guilatriche/rover/docs/journal/journal-2026-11-05.md

# Journal de bord du rover : 2026-11-05

> **Projet** : 243-6J7-LI (préparation 243-5J4-LI)  
> **Auteur** : Guillaume Retier  
> **Règle** : une entrée datée par séance. Aucun mot de passe ni jeton dans ce fichier.

**Sommaire** : [Résumé](#résumé) · [Lexique](#lexique) · [Ce qui a été fait](#ce-qui-a-été-fait) · [Problèmes rencontrés](#problèmes-rencontrés) · [Décisions](#décisions) · [À faire](#à-faire)

## Résumé

**En bref** : première preuve de concept de la commande des moteurs. Une broche de l'ESP32 (la carte de commande) envoie des impulsions à l'entrée S1 de la Sabertooth (la carte qui fait tourner les moteurs), à travers un transistor 2N3904 (un interrupteur électronique). Essais à la maison, avec le robot et un multimètre (pas d'oscilloscope), roues en l'air.

**Points clés**

- **Le montage commande bien la Sabertooth.** Le multimètre affiche la moyenne de la tension sur S1 : 400 mV à 1500 µs, 431 mV à 1600 µs, 455 mV à 1700 µs, conformes au calcul à 1 % près. Comme on n'a pas d'oscilloscope, c'est la preuve que les impulsions ont la bonne durée.
- **Réponse de la Sabertooth** : au-dessus du centre les roues avancent, en dessous elles reculent, avec la même vitesse de part et d'autre à écart égal. La vitesse augmente avec l'écart au centre.
- **Le centre (l'arrêt) est la largeur d'impulsion reçue à l'allumage de la Sabertooth.** Elle l'apprend elle-même (autocalibration) et le conserve quand seule l'ESP32 redémarre. Il a été décalé à 1400 µs, puis remis à 1500 µs, en allumant la Sabertooth au bon moment. Pourquoi c'est important : si la Sabertooth redémarre pendant que l'ESP32 envoie autre chose que 1500 µs, l'arrêt change et le robot peut bouger.
- **ESP32 coupée** (USB ou batterie) : les roues s'arrêtent en moins d'une seconde, parce que dans ce mode la Sabertooth s'arrête quand les impulsions cessent.
- **Programme figé** : sans protection, les roues ne s'arrêtent pas, car la partie de l'ESP32 qui fabrique les impulsions continue d'émettre seule. Avec une minuterie de surveillance de 2 s, l'ESP32 redémarre et les roues s'arrêtent.
- **Une entrée de la Sabertooth laissée sans branchement capte le bruit électrique** (S1 libre touchée au doigt, S2 sans branchement) et les roues bougent. Aucune entrée ne doit rester libre sur le circuit imprimé.

## Lexique

| Mot | Ce que c'est |
| --- | --- |
| ESP32 | La carte de commande : l'ordinateur du robot, qui envoie les ordres aux moteurs |
| Sabertooth | La carte qui fait tourner les moteurs d'après les ordres reçus |
| GPIO 18 | Une broche de l'ESP32 (une « sortie ») qui envoie le signal vers S1 |
| S1 et S2 | Les deux entrées de la Sabertooth par lesquelles elle reçoit les ordres : S1 pour un côté du robot, S2 pour l'autre |
| Mode radiocommande | La façon dont la Sabertooth lit ses ordres : comme ceux d'une télécommande de modèle réduit, par des impulsions |
| Impulsion, µs | L'ordre est la durée d'une impulsion, en microsecondes (µs). Environ 1500 µs = arrêt, moins = arrière, plus = avant |
| Centre | La largeur d'impulsion qui correspond à l'arrêt. Dans ce mode, la Sabertooth l'apprend toute seule à son allumage (autocalibration) |
| Transistor | Un interrupteur électronique : un petit courant sur une patte (la base) ouvre ou ferme le passage entre deux autres pattes |
| Résistance de rappel | Une résistance qui ramène un fil à une tension connue (ici 5 V) quand rien d'autre ne le pilote |
| Multimètre | L'appareil de mesure de tension. Trop lent pour suivre les impulsions, il en affiche la moyenne |
| Minuterie de surveillance | Un mécanisme qui redémarre l'ESP32 si son programme se bloque |
| 0 V, masse | Le point de référence de toutes les tensions, relié entre la Sabertooth et l'ESP32 |
| Roues en l'air | Les roues ne touchent pas le sol, pour que le robot ne parte pas en cas de problème |

## Ce qui a été fait

### Matériel

- ESP32 (carte LilyGO T-A7670E), alimentée par son câble USB ou par sa batterie.
- Contrôleur de moteurs Sabertooth Dual 5A Reg, 4 moteurs du châssis Lynxmotion A4WD1 (deux côtés de deux roues : S1 commande un côté, S2 l'autre).
- Pile lithium 3S (12,32 V mesurés) avec fusible de 3 A.
- Un transistor 2N3904 et deux résistances de 10 kΩ.
- Multimètre (tension continue). Pas d'oscilloscope ni d'alimentation de laboratoire pour cette séance.

### Montage

Brochage du 2N3904 (boîtier TO-92) : face plate vers soi, pattes vers le bas, de gauche à droite : émetteur (E), base (B), collecteur (C).

1. GPIO 18 de l'ESP32 → résistance R1 de 10 kΩ → base (B).
2. Émetteur (E) → masse commune. La masse de l'ESP32 (GND) est reliée au 0V du Sabertooth ; sans cette liaison, le signal n'a pas de référence commune.
3. Collecteur (C) → borne S1 du Sabertooth.
4. Collecteur (C) → résistance R2 de 10 kΩ (résistance de rappel) → borne 5V du Sabertooth.
5. Pile 3S → fusible de 3 A → bornes d'alimentation du Sabertooth. Une inversion de polarité détruit le contrôleur : vérifier le + et le − avant de brancher.
6. Interrupteurs du Sabertooth (la Sabertooth ne les lit qu'à l'allumage) : 1 bas et 2 haut = mode radiocommande ; 3 bas = coupure pour pile lithium (elle arrête les moteurs quand la tension de la pile devient trop basse, ce qui protège la pile) ; 4 bas = les deux côtés indépendants ; 5 haut = réponse linéaire ; 6 haut = radiocommande standard : la Sabertooth apprend seule le centre et coupe les moteurs quand les impulsions cessent.
7. Moteurs branchés, **roues en l'air** pour tous les essais ; pile à portée de main pour la débrancher.

Rôle des pièces :

- **Transistor** : interrupteur vers la masse. L'ESP32 sort 3,3 V ; le Sabertooth attend des impulsions de type radiocommande dont le niveau haut est celui de sa borne 5V. Le transistor ramène S1 à 0 V ou le laisse monter à 5 V (choix expliqué dans le dossier, section 12).
- **R1 (10 kΩ)** : limite le courant dans la base. Quand la broche est haute, ce courant vaut (3,3 V − 0,65 V) / 10 kΩ = 0,265 mA.
- **R2 (10 kΩ, rappel)** : ramène S1 vers 5 V quand le transistor est bloqué. L'entrée S1 n'a pas de résistance interne vers le haut (lue à −3 mV quand rien n'y est branché), donc sans R2, S1 ne pourrait pas monter.
- Le signal est **inversé** : broche haute, le transistor conduit et S1 est à 0 V ; broche basse, le transistor est bloqué et S1 monte à 5 V. L'impulsion vue par le Sabertooth est donc le moment où la broche est basse.

Programmes d'essai : `test_06_transistor_sabertooth`, `test_07_sabertooth_sequence`, `test_08_minuterie_surveillance` (dossier `firmware/tests`). Le module Arduino-ESP32 (le support de l'ESP32 dans le logiciel Arduino) doit être en version 3.x (fonction `ledcAttach`) ; la version exacte reste à noter.

### Le signal et la mesure au multimètre

Le signal se répète toutes les 20 ms (50 fois par seconde). Dans chaque cycle de 20 ms, pour une impulsion de 1500 µs (1,5 ms) :

```
|<------------------ 20 ms ------------------>|
| 1,5 ms          |          18,5 ms           |
| GPIO 18 BAS     |        GPIO 18 HAUT        |
| transistor      |        transistor          |
| bloqué          |        conduit             |
| S1 = 5 V        |        S1 ≈ 0 V            |
```

1,5 + 18,5 = 20. La largeur de l'impulsion est le temps t pendant lequel S1 est à 5 V.

Le multimètre est trop lent pour suivre ces pointes une à une : il affiche la **moyenne** de la tension sur le cycle. Si la tension vaut V_haut pendant le temps t et V_bas le reste des 20 ms :

moyenne = V_haut × (t / 20 ms) + V_bas × (1 − t / 20 ms)

Plus l'impulsion est longue, plus la moyenne monte. C'est ce qui permet de contrôler la largeur de l'impulsion avec un multimètre, faute d'oscilloscope.

### Valeurs mesurées, calcul de chacune

Sonde noire du multimètre sur la masse commune (GND) pour toutes les mesures. Sonde rouge à l'endroit indiqué.

| N° | Point (sonde rouge) | Mesuré | Calculé |
| --- | --- | --- | --- |
| M1 | Broche 3V3 | 3,3 V | 3,3 V |
| M2 | GPIO 18 (1500 µs) | 3,04 V | 3,05 V |
| M3 | Base, entre R1 et le transistor | 600 mV | 0,60 V |
| M4 | Collecteur, sans R2 | 17,74 mV | sans objet |
| M5 | Collecteur, avec rappel au 3V3 | 3,26 V | environ 0,28 V (non conforme) |
| M6 | Collecteur, rappel 10 kΩ au 3V3, câblage corrigé | 276 mV | 0,2475 V + V_bas (sert à déduire V_bas) |
| M7 | Pile 3S | 12,32 V | 9 à 12,6 V |
| M8 | Borne 5V du Sabertooth | 4,98 V | 5 V |
| M9 | S1 seule, rien branché dessus | −3 mV | 0 V |
| M10 | S1 / collecteur, rappel au 5V, 1500 µs | 400 mV | 402 mV |
| M11 | Même point, 1600 µs | 431,3 mV | 427 mV |
| M12 | Même point, 1600 µs | 430 mV | 427 mV |
| M13 | Même point, 1700 µs | 455 mV | 452 mV |

**Broche 3V3 (3,3 V).** Tension fixe de l'ESP32. Vérifie que le multimètre et la masse sont corrects avant les autres mesures.

**GPIO 18 (3,05 V).** À 1500 µs, la broche est basse 1,5 ms et haute 18,5 ms par cycle (voir le schéma). Haute, elle est à 3,3 V ; basse, à 0 V. Moyenne = (3,3 × 18,5 + 0 × 1,5) / 20 = 61,05 / 20 = 3,05 V. Le rapport 18,5 / 20 est la part du cycle où la broche est haute, soit 92,5 %.

**Base (0,60 V).** Quand la broche est haute (92,5 % du cycle), la jonction base-émetteur conduit et la base reste à environ 0,65 V (valeur typique d'un 2N3904, entre 0,6 et 0,7 V). Quand la broche est basse, la base est à 0 V. Moyenne = 0,65 × 0,925 = 0,60 V. En sens inverse, 600 mV / 0,925 = 0,649 V, ce qui est compatible avec cette valeur typique.

**Collecteur sans R2 (17,74 mV).** Sans résistance de rappel, rien ne fait monter la tension du collecteur quand le transistor est bloqué : la lecture reste proche de 0 V. Cette lecture a montré que R2 manquait.

**Collecteur avec rappel au 3V3 (environ 0,28 V attendus).** Le collecteur est à 3,3 V pendant 1,5 ms (transistor bloqué) et à V_bas pendant 18,5 ms (transistor conducteur). V_bas est la petite tension qui reste aux bornes du transistor conducteur. Partie haute : 3,3 × 1,5 / 20 = 0,2475 V, à laquelle s'ajoute une petite tension de l'ordre de 0,03 V (voir la déduction ci-dessous), soit environ 0,28 V. Le 3,26 V lu en M5 est presque la tension du rappel (3,3 V) : le collecteur restait presque tout le temps haut, ce qui n'est pas ce que le calcul prévoit. Le câblage a été corrigé ensuite.

**Déduction de V_bas (0,031 V).** En M6, 276 mV mesurés. Partie haute : 0,2475 V. Il reste 0,276 − 0,2475 = 0,0285 V, apporté par la partie basse, qui occupe 18,5 / 20 = 0,925 du cycle. V_bas = 0,0285 / 0,925 = 0,031 V. Cette valeur est utilisée pour les calculs suivants ; la ligne M6 sert donc à la déduire et non à la vérifier.

**Pile 3S (12,32 V).** Trois éléments lithium en série : un élément vaut 3,0 V (vide) à 4,2 V (plein), soit 9 à 12,6 V pour trois. 12,32 / 3 = 4,11 V par élément : pile presque pleine.

**Borne 5V du Sabertooth (4,98 V).** Le Sabertooth fournit 5 V sur cette borne. Le 4,98 V mesuré est utilisé comme V_haut pour les calculs de S1.

**S1 seule (−3 mV).** Aucune pièce n'est branchée sur S1 et la lecture est proche de 0 V : l'entrée n'a pas de résistance interne vers le haut. C'est pour cela que R2 est nécessaire.

**S1 / collecteur, rappel au 5V.** V_haut = 4,98 V, V_bas = 0,031 V, t = largeur de l'impulsion.

- 1500 µs : S1 est haut 1,5 / 20 = 0,075 du cycle, bas le reste (0,925). 4,98 × 0,075 + 0,031 × 0,925 = 0,3735 + 0,0287 = 0,402 V. Mesuré : 400 mV.
- 1600 µs : 1,6 / 20 = 0,080 (haut), 0,920 (bas). 4,98 × 0,080 + 0,031 × 0,920 = 0,3984 + 0,0285 = 0,427 V. Mesuré : 431,3 mV et 430 mV.
- 1700 µs : 1,7 / 20 = 0,085 (haut), 0,915 (bas). 4,98 × 0,085 + 0,031 × 0,915 = 0,4233 + 0,0284 = 0,452 V. Mesuré : 455 mV.

Les écarts sont de −0,5 % (1500 µs), +1,0 % et +0,7 % (1600 µs) et +0,7 % (1700 µs).

**Courants à l'état conducteur.** I_B = (3,3 − 0,65) / 10 kΩ = 0,265 mA. I_C = 4,98 V / 10 kΩ = 0,50 mA (courant du rappel R2). I_C / I_B = 1,9, très inférieur au gain d'un 2N3904 : le transistor est saturé, donc il agit comme un interrupteur fermé.

**Résolution du programme.** duty = 65535 × (20000 − t) / 20000 (16 bits, 50 Hz). Un pas du générateur vaut 20 ms / 65536 = 0,31 µs. Pour 1500 µs, duty = 60619. Pourquoi : le réglage est assez fin pour fixer la largeur d'impulsion à moins de 1 µs près.

**En résumé.** Les mesures du multimètre, comparées au calcul, ne s'écartent que de 1 % au plus : le transistor donne bien des impulsions de la largeur voulue, et il fonctionne comme un interrupteur fermé quand il conduit. On peut donc se fier au montage pour la suite des essais, même sans oscilloscope.

### Essais

Procédure pour reproduire les essais de commande :

1. Pile du Sabertooth débranchée, téléverser le programme d'essai dans l'ESP32 (roues en l'air).
2. Pour fixer le centre à 1500 µs : ESP32 en marche avec le programme `test_06_transistor_sabertooth` (`PULSE_US = 1500`), couper l'interrupteur de la pile 12 V pendant 2 s, puis le rallumer. Les roues de S1 restent immobiles. Pourquoi : la Sabertooth prend pour centre la largeur reçue à son allumage ; l'allumer pendant que l'ESP32 envoie 1500 µs fixe donc l'arrêt à 1500 µs.
3. Téléverser ensuite le programme d'essai (`test_07_sabertooth_sequence` ou `test_08_minuterie_surveillance`) sans toucher à l'interrupteur 12 V : le centre reste à 1500 µs.
4. Noter, pour chaque largeur envoyée, si les roues de S1 tournent, dans quel sens et à quelle vitesse approximative. La valeur en cours est affichée sur le port série (115200) ; le début du démarrage peut manquer à l'écran après un redémarrage par USB.
5. Ne pas poser la pointe du multimètre sur le collecteur pendant que les roues tournent : cela les perturbe (voir le problème 6).

Chaque essai est présenté avec son but, ses conditions, son résultat et ce qu'on en conclut.

| N° | But | Conditions de test | Résultats | Conclusion |
| --- | --- | --- | --- | --- |
| 1 | Vérifier que les roues restent immobiles quand l'ESP32 envoie la largeur d'arrêt | 1500 µs constant | Roues immobiles | La largeur de 1500 µs est reconnue comme l'arrêt |
| 2 | Voir si une largeur différente de 1500 µs fait tourner les roues | 1600 µs envoyé en continu | Roues immobiles | Preuve de l'autocalibration : la Sabertooth avait pris 1600 µs pour centre à son allumage |
| 3 | Voir si les roues tournent au-dessus du centre et s'arrêtent au centre | 1500 µs pendant 5 s, puis 1600 / 1500 / 1700 / 1500 | Rotation à 1600 et 1700 µs, arrêt à 1500 µs | Les roues avancent au-dessus du centre et s'arrêtent au centre |
| 4 | Vérifier que le redémarrage de l'ESP32 ne fait pas bouger les roues | 1500 µs constant ; pile branchée, puis redémarrage de l'ESP32 | Roues immobiles | Le redémarrage de l'ESP32 seule ne fait pas bouger les roues |
| 5 | Vérifier que l'effet de 1600 µs et de 1500 µs se répète | 1500 µs pendant 5 s, puis 1600 / 1500 en boucle | Arrêt à 1500 µs, rotation à 1600 µs | Le comportement est répétable |
| 6 | Comparer l'avant et l'arrière à écart égal avec le centre | 1500 µs pendant 5 s, puis 1600 / 1500 / 1400 / 1500 | 1400 µs : arrière ; 1500 µs : arrêt ; 1600 µs : avant ; même vitesse à 1400 et à 1600 µs | La réponse est symétrique autour du centre |
| 7 | Voir ce qui arrive si la Sabertooth est allumée pendant que l'ESP32 envoie 1400 µs | Même programme ; Sabertooth allumée pendant la phase à 1400 µs | Arrêt à 1400 µs, 1500 µs avant lent, 1600 µs avant plus rapide | Le centre est devenu 1400 µs : la Sabertooth prend pour centre la largeur reçue à son allumage |
| 8 | Confirmer que le point d'arrêt dépend du moment où l'on allume la Sabertooth | Centre décalé en manœuvrant seulement l'interrupteur de la pile 12 V, ESP32 en marche | Le point d'arrêt change | Le point d'arrêt dépend de l'instant de l'allumage |
| 9 | Voir si le centre est conservé quand seule l'ESP32 redémarre | Redémarrage de l'ESP32 seule, Sabertooth restée allumée depuis l'essai précédent ; programme : 1500 µs pendant 5 s, puis 1600 µs | Roues en rotation pendant 5 s, arrêt à 1600 µs | Le centre reste en mémoire (1600 µs) quand seule l'ESP32 redémarre |
| 10 | Remettre le centre à 1500 µs | 1500 µs constant ; pile 12 V coupée 2 s puis rallumée | Roues immobiles | Une coupure de 2 s avec 1500 µs envoyé remet le centre à 1500 µs |
| 11 | Voir si les roues s'arrêtent quand l'ESP32 est coupée | Roues à 1600 µs ; câble USB de l'ESP32 débranché | Roues arrêtées en moins d'une seconde | Dans ce mode, la Sabertooth s'arrête quand les impulsions cessent |
| 12 | Vérifier que c'est pareil quand l'ESP32 est alimentée par sa batterie | Même essai ; ESP32 sur sa batterie seule | Même résultat ; à la remise sous tension, rotation reprise après environ 5 s (fin de la phase à 1500 µs) | Même conclusion, quelle que soit l'alimentation de l'ESP32 |
| 13 | Voir ce qui arrive aux roues quand le programme de l'ESP32 se fige, sans protection | Programme figé volontairement après le passage à 1600 µs, sans minuterie | Les roues ne s'arrêtent pas | Un programme figé laisse les roues sur la dernière vitesse : la partie de l'ESP32 qui fabrique les impulsions continue d'émettre seule |
| 14 | Vérifier que la minuterie de surveillance redémarre l'ESP32 et arrête les roues | Programme figé à 10 s, avec minuterie de surveillance de 2 s | L'ESP32 redémarre (message `rst:0xc (SW_CPU_RESET)`, qui indique un redémarrage commandé par le logiciel), les roues s'arrêtent ; `Impulsion : 1500 us` apparaît 0,19 s après le début du démarrage | La minuterie règle le cas du programme figé |
| 15 | Voir l'effet d'une entrée sans branchement | S1 libre (M9) | Un doigt sur le fil de S1 fait tourner les roues d'un côté | Une entrée libre capte le bruit : aucune entrée ne doit rester libre sur le circuit imprimé |
| 16 | Voir l'effet de S2 laissée sans branchement | S2 sans branchement toute la soirée | Ses roues tournent parfois seules : quand on touche son fil, quand son fil est approché de la pointe du multimètre posée sur le collecteur (ESP32 alimentée sur USB ou sur batterie), et de temps en temps pendant l'arrêt des roues de S1 | Même conclusion : relier S2 (voir À faire, B1) |
| 17 | Vérifier que ces mouvements viennent de l'ESP32 alimentée | ESP32 hors tension (USB débranché, batterie éteinte), pile du Sabertooth branchée | Aucune roue ne tourne | Les roues ne bougent pas quand l'ESP32 est hors tension |

Les essais du début de séance (dont l'essai 2, et d'autres non repris ici) ont eu lieu avant qu'on ait compris que le centre dépend du moment de l'allumage. On n'y avait pas noté si la Sabertooth était déjà allumée quand l'ESP32 envoyait les impulsions.

## Problèmes rencontrés

| # | Problème | Cause | Correctif |
| --- | --- | --- | --- |
| 1 | 17,74 mV au collecteur | Pas de résistance de rappel branchée | Résistance de 10 kΩ ajoutée |
| 2 | 3,26 V au collecteur avec le rappel (attendu ~0,28 V) | Câblage du transistor | Câblage corrigé ; 276 mV ensuite |
| 3 | 1,5 mV lus sur GPIO 18  | Masse du multimètre | Mesure écartée ; mesures suivantes conformes |
| 4 | L'arrêt change d'un démarrage à l'autre (début de séance) | Le Sabertooth prend pour centre la largeur reçue à son allumage | Démarrer toujours à 1500 µs ; voir À faire |
| 5 | Roues qui tournent quand on touche une entrée libre | Entrée sans branchement | Relier S2 ; aucune entrée libre sur le circuit imprimé |
| 6 | Pointe du multimètre sur le collecteur qui accélère des roues (sur S1 une première fois, sur S2 plus tard) | Cause non identifiée | Ne pas mesurer pendant que les roues tournent ; oscilloscope |
| 7 | Programme figé : les roues gardent la dernière vitesse | La partie de l'ESP32 qui fabrique les impulsions continue d'émettre seule, même quand le programme est bloqué | Minuterie de surveillance qui redémarre l'ESP32 |
| 8 | Roue de S1 qui rampe très lentement environ 2 s après l'arrêt, de temps en temps, vitesse variable | Cause non identifiée | À revoir au sol avec la charge du robot et à l'oscilloscope |
| 9 | Mouvements à la mise sous tension du Sabertooth (une paire d'environ 1 s lors d'une mise sous tension, l'autre paire d'environ un tour lors d'une autre) | Cause non identifiée ; non reproduits en redémarrant seulement l'ESP32 | À revoir à l'oscilloscope (comportement de GPIO 18 et des entrées à l'allumage) |

## Décisions

| Sujet | Décision | Pourquoi | Statut |
| --- | --- | --- | --- |
| Démarrage du programme du robot | Toujours 1500 µs au départ, et rester à 1500 µs tant que le serveur n'envoie pas d'ordre | La Sabertooth prend pour centre la largeur reçue à son allumage (essais 7 à 10) : si l'ESP32 envoie autre chose, l'arrêt est décalé et les roues bougent | Retenue (5 novembre) |
| Programme figé | Conserver la minuterie de surveillance ; délai de 2 s à fixer. La remise à zéro ne doit se faire que quand le travail utile est fait | Sans elle, un programme bloqué laisse les roues sur le dernier ordre (essai 13) ; avec elle, l'ESP32 redémarre et les roues s'arrêtent (essai 14). Remise à zéro seulement après le travail utile, sinon un blocage ne serait pas détecté | Retenue (5 novembre) |

## À faire

| Réf. | Tâche |
| --- | --- |
| B1 | Relier S2 à 0V (ou lui donner un signal) et refaire les essais ; les observations de S1 ne doivent plus être mélangées avec celles de S2 |
| B2 | Oscilloscope (cégep) : largeur d'impulsion autour de 1500 µs (±20 µs), niveaux ≥ 4,5 V et ≤ 0,5 V, comportement de GPIO 18 au démarrage et au redémarrage |
| B3 | Chronométrer le délai entre le blocage et l'arrêt (minuterie de 2 s) et le délai d'arrêt à la coupure de l'ESP32 |
| B4 | Allumage du Sabertooth et état sûr : choisir la solution (interrupteur sur l'alimentation du Sabertooth, relais ou transistor PNP / MOSFET à canal P, commandé par l'ESP32 ; interrupteur 6 en bas, sans coupure automatique ; mode analogique) |
| B5 | Question 10 du dossier : délai de la coupure automatique du Sabertooth quand les impulsions cessent |
| B6 | Refaire les essais au sol, avec la charge du robot (ramper, arrêt, démarrage) |
| B7 | Noter la version d'Arduino-ESP32 utilisée (`ledcAttach`, `esp_task_wdt_reconfigure`) |
| B8 | Mettre à jour le dossier (conception préliminaire, preuve de concept) avec ces résultats |
