guilatriche/rover/docs/journal/journal-2026-10-26.md

# Journal de bord du rover : 2026-10-26

> **Projet** : 243-6J7-LI (préparation 243-5J4-LI)  
> **Auteur** : Guillaume Retier  
> **Heures** : locales (UTC − 4), sauf mention « UTC » (la VM est en UTC)  
> **Règle** : une entrée datée par séance. Aucun mot de passe ni jeton dans ce fichier.

**Sommaire** : [Résumé](#résumé) · [Ce qui a été fait](#ce-qui-a-été-fait) · [Problèmes rencontrés](#problèmes-rencontrés) · [Décisions](#décisions) · [À faire](#à-faire)

## Résumé

**En bref** : suite du diagnostic des pertes de liaison du robot (passages à `lost`, LED éteinte) commencé le 25 octobre ; en après-midi et en soirée, cahier des charges et premiers essais matériels.

**Points clés**

- **L'essai en câble Ethernet n'a pas pu se faire.** Le câble du portable est sur un réseau différent (`192.168.9.x`) de celui du Wi-Fi où se trouve le robot (`192.168.202.x`), et le routeur n'a pas de second port. Comme la VM passait par la carte Wi-Fi, couper le Wi-Fi a coupé le SSH. Retour au montage du 25 octobre.
- **La version de diagnostic du programme du robot est téléversée** et fonctionne. À chaque perte, le robot affiche le silence mesuré (1001 ms, soit le seuil), l'état de MQTT (connecté), le niveau Wi-Fi, l'adresse du point d'accès (`bssid`) et le canal.
- **Le retard semble se situer sur le dernier trajet, en Wi-Fi, vers le robot** : le broker n'a vu aucun trou de signes de vie pendant les pertes observées, alors que le robot, lui, voit des silences de 1 à 1,6 s. C'est une déduction, pas une mesure directe du Wi-Fi. Le Wi-Fi de la résidence (au moins 80 appartements, de nombreux points d'accès) est chargé dans le 2,4 GHz, la seule bande de l'ESP32.
- **Décision** : garder le programme et le délai de perte de liaison de 1 s. Voir plus tard s'il faut accepter une tolérance de plus d'une seconde.
- **Cahier des charges (243-5J4-LI) : version 3 produite** (24 pages), adaptée au fait que le pont en H est un module du commerce (vu avec Tristan, pas besoin d'en concevoir un).
- **Premiers essais matériels avec la vraie pile et le vrai contrôleur de moteurs** : pile lithium récupérée (12,5 V mesurés), contrôleur identifié (Sabertooth Dual 5A Reg), essais au potentiomètre. Résultat de fin de séance : **S1 commande les roues d'un côté et S2 celles de l'autre**. Le comportement d'une voie à pleine vitesse (18 h 39 à 18 h 44) s'explique : l'entrée S2 n'avait pas de potentiomètre et sa valeur enregistrée était haute ; avec un deuxième potentiomètre sur S2, tout est normal. Mesures de courant et réglage de la coupure lithium **non faits**.

## Ce qui a été fait

### Essai en câble Ethernet (abandonné)

1. Portable branché en Ethernet (carte Realtek). Wi-Fi à couper pour isoler le Wi-Fi du portable.
2. Couper le Wi-Fi a fait perdre l'accès SSH : la carte réseau de la VM VirtualBox est en accès par pont sur la carte Wi-Fi (Intel AX200).
3. La VM a ensuite pris l'adresse `192.168.9.156` (réseau du câble), et non `192.168.202.76`. Le câble est donc sur un autre réseau (VLAN différent). Le programme du robot vise `192.168.202.76` : le robot n'aurait plus trouvé le broker.
4. Le routeur n'a pas d'autre port : essai abandonné. Pont de la VM remis sur la carte Wi-Fi, `ip -br a` pour retrouver `192.168.202.76` (la carte réseau de la VM n'avait plus d'adresse après `netplan apply` tant que le Wi-Fi n'était pas revenu). Résultat final constaté : « c'est bon ».

### Programme de diagnostic du robot

Téléversé vers 9 h 58 : champs `reset` (cause du dernier redémarrage) et `silence` (temps écoulé depuis le dernier signe de vie) dans le statut, messages série détaillés, `WiFi.setSleep(false)`. Version suivante (vers 10 h 17) : ajout de l'adresse du point d'accès (`bssid`) et du canal dans le message de perte, dans le statut et dans le message de connexion. Troisième version (10 h 29) : essai optionnel qui **force** le robot sur un point d'accès choisi (`FORCER_POINT_ACCES`, adresse et canal dans le code). Ces versions n'ont pas été compilées hors de l'IDE Arduino avant le téléversement.

### Mesures sur les pertes de liaison

| Heure (locale) | Observation |
| --- | --- |
| 9 h 58 à 10 h 00 | Pertes à 09:58:52 et 10:00:18 (silence 1001 ms, MQTT connecté), signal du robot de −84 à −86 dBm ; lien rétabli en 0,16 s (09:58:52) |
| 10 h 05 | Trois pertes en 8 s : 10:05:04, 10:05:10 et 10:05:11 (−79 à −84 dBm) ; rétablissement en 0,3 à 0,6 s. La fenêtre de détection des trous de signes de vie au broker (lancée vers 10 h 01) n'a affiché aucun trou |
| 10 h 17 | Robot rapproché du point d'accès (environ 1 m, en l'air) : −63 à −65 dBm ; pertes à 10:17:39 et 10:17:41 quand même |
| 10 h 29 à 10 h 31 | Robot forcé sur le point d'accès `74:83:C2:91:F8:11` (canal 11), accepté avec le même mot de passe, signal −74 à −77 dBm ; pertes à 10:29:55, 10:30:08, 10:30:55 et 10:31:12 (4 en 1 min 20) |
| 10 h 30 à 10 h 32 | `ping` horodaté depuis le portable vers le robot : aucune perte de réponse, mais des pics de 300 à 800 ms toutes les 2 à 6 s entre des réponses de 5 à 50 ms. La perte de 10:30:55 (silence commencé vers 10:30:54,45) coïncide avec une réponse de 735 ms. Pour 10:31:12, le rapprochement est moins net |

### Environnement Wi-Fi

- **Portable** (Intel AX200) : connecté à `78:45:58:2e:8b:75`, 5 GHz, canal 44, −41 dBm. Cette adresse correspond à l'étiquette du point d'accès UniFi AC Mesh (UAP-AC-M) photographié, `78:45:58:2C:8B:75` (lecture de la photo à vérifier). À 10 h 20, le portable a été mis sur « ILO 315 2G » pour comparaison : `b4:fb:e4:91:8e:d3`, canal 1, −57 dBm.
- **Robot** : sur `18:E8:29:FE:39:0F`, 2,4 GHz, canal 11, 3 appareils connectés. Il s'agit d'un autre appareil que celui de la photo.
- **Liste des réseaux visibles** (`netsh wlan show networks mode=bssid`) : le nom « ILO 315 2G » est diffusé par une quinzaine d'adresses différentes (canaux 1, 6 et 11), et « ILO 315 5G » par une dizaine. Ce sont des points d'accès de la résidence, gérés ensemble (au moins 80 appartements), qui acceptent les mêmes identifiants.
- **Charge du canal** annoncée par les points d'accès : 36 à 70 % en 2,4 GHz (69 % pour le point d'accès d'origine du robot), 1 à 22 % en 5 GHz. L'ESP32 ne sait utiliser que le 2,4 GHz.
- Quelques points d'accès 2,4 GHz relevés, depuis la position du portable : `74:83:c2:91:f8:11` (canal 11, 78 %, charge 36 %), `18:e8:29:51:c8:a0` (canal 11, 62 %, charge 25 %), `b4:fb:e4:91:8e:d3` (canal 1, 85 %, charge 47 %), `78:45:58:2d:8b:75` (AC Mesh, canal 1, 83 %, charge 52 %).

### Ce qui est établi et ce qui ne l'est pas

- **Établi par les mesures** : le broker ne voit aucun trou de signes de vie pendant les pertes observées (fenêtre de détection vide) ; le robot voit des silences de 1001 ms avec MQTT connecté ; le lien revient en 0,07 à 0,8 s ; les pertes continuent avec deux points d'accès différents, à −63 et à −75 dBm ; le `ping` vers le robot montre des pics répétés de 300 à 800 ms, dont un en même temps que la perte de 10:30:55.
- **Probable, non démontré** : le retard vient du dernier trajet Wi-Fi jusqu'au robot, dans un 2,4 GHz chargé.
- **Non expliqué** : pourquoi les pertes persistent à un meilleur signal, et pourquoi le signal du robot est à −84 dBm à environ 1,8 m du point d'accès à un moment donné (cause non identifiée : position de l'ESP32, point d'accès différent de celui supposé, ou antenne).
- Le redémarrage inexpliqué du 25 octobre n'a pas été revu : le champ `reset` n'a pas encore été relevé dans le statut.

### Cahier des charges (5J4), version 3

Fichier `243-5J4-LI_Cahier_des_charges-Guillaume_RETIER_v3.docx`, 24 pages, construit à partir de la consigne du laboratoire et du cours. À 15 h 42, information de Tristan : le pont en H est un module du commerce, récupéré depuis. Dossier modifié en conséquence ; une carte sera faite dans tous les cas (voir Décisions) ; sa fonction exacte reste à préciser. Le dossier ne mentionne pas encore la référence du contrôleur ni les valeurs de pile vues le soir (voir À faire).

### Pile et contrôleur de moteurs

**Pile** (récupérée au magasin, photo à 16 h 05) :
- Étiquette : « BATTERIE TSO », « PILE0034-010 », « R1-A01 ». Étiquette d'avertissement de type pile au lithium. Un petit connecteur blanc à 4 broches porte le marquage « 3S » : d'après le marquage, c'est la prise d'équilibrage (3 éléments), qui ne sert pas sur le robot. Les fils de puissance rouge et noir sont de l'autre côté.
- **Tension mesurée au multimètre : 12,5 V** (17 h 44). Pour 3 éléments en série, une pile pleine est à environ 12,6 V (valeur usuelle, à confirmer sur la fiche de la pile).
- **Inconnus** : type exact (LiPo ou Li-ion), capacité en mAh, chargeur compatible (il faut un chargeur lithium 3S avec équilibrage, pas celui des piles NiMH).

**Fusible** : 3 A, sur le châssis d'origine (le courant réel n'est pas encore mesuré).

**Contrôleur de moteurs** (photos 17 h 46 et 17 h 49) :
- Étiquette de RobotShop : « Dimension Engineering Sabertooth Dual 5A Reg ». Étiquette du magasin du cégep : « CARTE0013-26 R6-G3 ».
- Valeurs du fabricant, tirées du manuel (https://www.dimensionengineering.com/datasheets/Sabertooth2x5.pdf), **non mesurées** : 5 A continu et 10 A de pointe par voie, alimentation de 6 à 18 V, protection thermique, freinage régénératif (pas de dissipateur : une équerre en aluminium sous le contrôleur). Le manuel prévient qu'il faut alimenter avec une pile, jamais avec une alimentation de laboratoire seule.
- Bornes : B+ / B−, M1A / M1B, M2A / M2B, bloc de commande « 0V 5V S1 S2 ».
- **Interrupteurs DIP** : le 4 en bas, les cinq autres en haut. D'après le manuel : mode analogique, coupure lithium **désactivée**, modes indépendants, réponse linéaire, pleine plage. Aucune modification des interrupteurs pendant la séance, donc la coupure lithium (interrupteur 3) reste désactivée.
- Mode analogique selon le manuel : S1 et S2 entre 0 V (marche arrière à vitesse maximale), 2,5 V (arrêt) et 5 V (marche avant à vitesse maximale).

### Essais au potentiomètre (18 h 02 à 19 h 05)

Montage : potentiomètre de 10 kΩ, extrémités sur 0V et 5V, curseur sur S1 ou S2, l'autre entrée laissée libre. Roues en l'air, un côté après l'autre au début.

**Ce qui est établi** : à 19 h 05, une entrée commande un côté et l'autre entrée l'autre côté. Ce qui avait semblé être un problème (voie à pleine vitesse, potentiomètre sans effet sur ce côté) venait de l'entrée S2, qui n'avait pas de potentiomètre : sa valeur enregistrée était haute. Ce n'était pas une panne. Constat avec le deuxième potentiomètre sur S2 : S1 commande un côté et S2 l'autre.

**Non fait** :
- La mesure de tension entre M2A et M2B n'a pas été faite : elle n'est plus nécessaire.

**Pas encore vérifié** : arrêt de toutes les roues avec les deux potentiomètres au milieu ; sens identique des deux roues d'un même côté ; sens d'avance identique pour les deux côtés ; courant (fusible de 3 A intact pendant ces essais, aucune coupure rapportée).

## Problèmes rencontrés

| # | Problème | Cause | Correctif |
| --- | --- | --- | --- |
| 1 | Perte de l'accès SSH en coupant le Wi-Fi du portable | La VM est en accès par pont sur la carte Wi-Fi | Pont remis sur la carte Wi-Fi ; essai Ethernet abandonné |
| 2 | VM en `192.168.9.156` sur le câble | Le câble est sur un autre réseau que le Wi-Fi (`192.168.202.x`) | Retour au Wi-Fi ; `ip -br a` pour retrouver `192.168.202.76` |
| 3 | `not authorised` en lançant les fenêtres de mesure | Variable `P` (mot de passe du broker) vide dans la nouvelle fenêtre SSH | Définir `P` dans chaque fenêtre (`read -rs`), vérifier `echo ${#P}` |
| 4 | Pertes de liaison du robot, environ une par minute par moments | Probablement le Wi-Fi vers le robot (voir plus haut), non démontré | Voir À faire |
| 5 | Mot de passe du broker tapé par erreur à l'invite d'un terminal (donc dans l'historique de la session) | Erreur de manipulation | Entrée d'historique à effacer ; mot de passe à renouveler (voir À faire) |
| 6 | Un côté à pleine vitesse sans réagir au potentiomètre | Entrée S2 sans potentiomètre : valeur enregistrée haute (pas une panne) | Deuxième potentiomètre branché sur S2 ; S1 et S2 commandent chacune un côté |

## Décisions

| Sujet | Décision | Statut |
| --- | --- | --- |
| Programme du robot | Garder le programme et la logique d'arrêt actuels : arrêt dès qu'aucun signe de vie n'est reçu pendant 1 s, effacement de la commande, aucun redémarrage seul | Validée (26 octobre) |
| Délai de perte de liaison | 1 s conservé. Voir plus tard s'il faut accepter une tolérance de plus d'une seconde (par exemple 2 s), à peser avec la distance parcourue après une vraie perte et à valider avec Tristan | À trancher plus tard |
| Wi-Fi de la résidence | Considéré comme un banc d'essai, pas comme la liaison finale du robot : le 2,4 GHz y est chargé. Ne pas chercher à « corriger » ces pertes dans le code pour le moment | Validée (26 octobre) |
| Essai Ethernet | Abandonné : pas de second port sur le bon réseau | Close |
| Pont en H | Module du commerce récupéré, pas de conception à faire | Validée avec Tristan (26 octobre) |
| Carte (PCB) | Faire une carte dans tous les cas : tout y relier (ESP32, contrôleur de moteurs, piles, capteurs) et y placer plusieurs points de mesure pour faciliter les diagnostics | Décidée (26 octobre) ; fonction exacte à préciser |
| Mesures sur la page de pilotage | Afficher aussi sur la page les valeurs mesurées : tension des piles (robot et ESP32), courant, accéléromètre, etc. | Décidée (26 octobre) ; à préciser |
| Pile des moteurs | Pile lithium 3S récupérée (12,5 V). Elle remplace la pile NiMH 12 V envisagée (journal du 25 octobre, D3) pour les essais | Constat, à confirmer avec Tristan pour le projet final |

## À faire

### Priorité 1 : liaison du robot

| Réf. | Tâche | Critère de réussite |
| --- | --- | --- |
| A1 | Relever le résultat de l'essai de 20 minutes sur le point d'accès forcé (démarré à 10 h 29) : nombre de `[LIEN] perdu`, trous vus au broker, timeouts du `ping` | Nombre de pertes noté et comparé à celui du 25 octobre et du début de séance |
| A2 | Remettre le portable en 5 GHz (« ILO 315 5G », canal 44) et noter l'heure du retour | Portable en 5 GHz ; VM de nouveau en `192.168.202.76` |
| A3 | Relever le champ `reset` dans le statut pour vérifier la cause d'un éventuel redémarrage de l'ESP32 | Cause notée (`poweron`, `software`, `brownout`, etc.) |
| A4 | Trancher la tolérance au retard (1 s, 2 s ou autre) avec Tristan | Valeur retenue, avec la distance d'arrêt correspondante |
| A5 | Envisager un point d'accès personnel (petit routeur sur un canal peu chargé) pour les essais, ou un essai par la 4G de l'ESP32 (carte LilyGO) plus tard | Choix noté |
| A6 | Avant de publier le programme dans le dépôt : remettre `FORCER_POINT_ACCES` à `0` et décider quelle version est publiée (version de diagnostic ou ancienne) | Dépôt sans adresse de point d'accès codée en dur |
| A7 | Vérifier la lecture de l'étiquette de l'AC Mesh (`78:45:58:2C:8B:75`) | Adresse confirmée |

Conditions de mesure : NordVPN fermé, une seule VM allumée (VirtualBox), moniteur série et câble USB non manipulés pendant la mesure, onglet de la page visible avec les signes de vie actifs.

### Priorité 2 : sécurité et suivi

| Réf. | Tâche | Statut |
| --- | --- | --- |
| B1 | Effacer de l'historique SSH la ligne où le mot de passe du broker a été tapé par erreur (`history -d`, `history -w`) | À faire |
| B2 | Changer le mot de passe du broker, puis mettre à jour `secrets.h` et la connexion de la page de pilotage | À faire, après les essais en cours |
| B3 | Remettre la configuration automatique du Wi-Fi de Windows et remettre 3CX en marche si besoin | À faire |

### Priorité 3 : moteurs et puissance

| Réf. | Tâche | Critère de réussite |
| --- | --- | --- |
| C1 | Mesurer le courant par côté, roues en l'air, multimètre en série après le fusible de 3 A, potentiomètre à 25, 50 et 100 %, puis blocage bref (1 s au plus) ; noter si le fusible saute | Courant relevé, comportement du fusible noté |
| C6 | Relire les six positions des interrupteurs sur le contrôleur (aucun n'a été touché pendant les essais) et vérifier que S1 = un côté et S2 = l'autre côté à chaque essai | Positions notées, comportement indépendant confirmé |
| C7 | Faire les 4 vérifications de fin de séance (milieu = arrêt, sens des deux roues d'un côté, sens d'avance des deux côtés) | Quatre points cochés |
| C8 | Pour tout essai : un potentiomètre (ou une tension fixe de 2,5 V) sur chaque entrée S1 et S2, jamais une entrée laissée libre | Les deux entrées toujours reliées |
| C9 | Régler la coupure lithium (interrupteur 3) quand les positions sont confirmées | Interrupteur réglé selon le manuel, noté |
| C10 | Trouver le type (LiPo ou Li-ion) et la capacité de la pile, demander au magasin un chargeur 3S compatible | Valeurs notées, chargeur obtenu |
| C11 | Mettre à jour le cahier des charges (v3.1) et le suivi des heures du 26 octobre | Dossier à jour (référence du contrôleur, pile, mode de commande) |

Voir aussi le journal du 25 octobre (C2 à C5 : rotation sur place, commande avec vitesse signée et rotation, arrêt et plafond de vitesse). Valeurs du fabricant pour ce châssis, non mesurées sur ce robot : charge utile d'environ 2,3 kg, courant de blocage d'environ 1,5 A par moteur.

Commande finale (idée, pas essayée) : l'ESP32 pourrait envoyer ses ordres au contrôleur de trois façons : tension analogique (comme les potentiomètres), impulsions de type télécommande (1000 à 2000 µs, 1500 µs = arrêt) ou messages en série. Choix à faire avec le réglage des interrupteurs DIP du contrôleur et avec la conception de la carte (fonction exacte à préciser).

---

← [Journal du 25 octobre](journal-2026-10-25.md)
