guilatriche/rover/docs/journal/journal-2026-10-23.md

# Journal de bord du rover : 2026-10-23

> **Projet** : 243-6J7-LI (préparation 243-5J4-LI)  
> **Auteur** : Guillaume Retier  
> **Règle** : une entrée datée par séance. Aucun mot de passe ni jeton dans ce fichier.

**Sommaire** : [Résumé](#résumé) · [Ce qui a été fait](#ce-qui-a-été-fait) · [Problèmes rencontrés](#problèmes-rencontrés) · [Décisions](#décisions) · [À faire](#à-faire) · [Questions ouvertes](#questions-ouvertes)

## Résumé

**En bref** : le trajet complet fonctionne. L'ESP32 publie en Wi-Fi vers Mosquitto (dans la VM), et les messages « bonjour N » arrivent en direct dans la page HiveMQ par le tunnel Cloudflare, en `wss` sur le port 443.

**Points clés**

- Projet cadré : mission, V1, hors V1.
- VM et Docker installés ; le broker accepte les connexions locales (1883) et WebSocket (9001).
- Commande des moteurs pas encore faite : la prochaine étape est une LED pilotée par MQTT, avec arrêt automatique.

## Ce qui a été fait

### Matériel

- **Disponible** : châssis Lynxmotion 4WD1 (4 moteurs Hsiang Neng HN-GH12-2217Y, 12 V, 200 tr/min, batterie 10,8 V, fusible 3 A), carte ESP32 LTE (LilyGO T-A7670E), protoboard, accéléromètre, détecteur de mouvement, capteur météo, ordinateur portable.
- **Manquant** : driver (pont en H) ou module, alimentation de banc, multimètre, caméra. Le cégep est fermé.

### Environnement : VM, Docker, Mosquitto, ESP32

| Élément | Valeur |
| --- | --- |
| Hôte | Windows, x64, VirtualBox 7.2.22 |
| VM | `vm-rover`, 4096 Mo de mémoire, 2 processeurs, disque de 25 Gio, accès par pont |
| Système | Ubuntu Server 26.04.1 LTS, machine `rover` |
| Logiciels | Docker, Docker Compose, Git ; Mosquitto 2 (`eclipse-mosquitto:2`) dans `~/rover-stack` |
| Broker | Port 1883 (MQTT) et port 9001 (WebSocket), accès anonyme refusé |
| ESP32 | Carte A7670E, Arduino IDE (cœur ESP32 3.3.8, PubSubClient 2.8), Wi-Fi 2,4 GHz |
| Test | L'ESP32 publie « bonjour N » chaque seconde sur `rover/rover-01/test` ; réception vérifiée avec `mosquitto_sub` dans la VM |
| Instantanés VirtualBox | Après Docker, puis « mosquitto » ; à faire : « tunnel-cloudflare » |

Les identifiants Wi-Fi et MQTT sont dans `secrets.h` côté ESP32 et dans `mosquitto/config/passwd` côté serveur. Ils ne sont pas notés ici et ne doivent jamais être publiés sur GitHub.

### WebSocket, HiveMQ et tunnel Cloudflare

Le broker est consultable depuis un navigateur, en local par le port 9001 et depuis Internet par `rover.gretier.xyz` sur le port 443, chiffré en `wss`.

1. **WebSocket local.** Ajout dans `mosquitto.conf` d'un second port : `listener 9001` et `protocol websockets`, et publication du port 9001 dans `docker-compose.yml`.
2. **Test avec HiveMQ WebSocket Client** (`hivemq.com/demos/websocket-client`) : port 9001, SSL décoché. Abonner le sujet `rover/rover-01/test` en le tapant à la main (le broker refusait la première saisie : « Invalid subscription string »).
3. **Tunnel Cloudflare `rover-vm`.** Créé dans le tableau de bord (Networking, Tunnels, Cloudflared, Docker). Le jeton est rangé dans `~/rover-stack/.env` (permissions 600), lu par le service `cloudflared` du `docker-compose.yml`. Quatre connexions enregistrées, état Healthy.
4. **Route publiée** : `rover.gretier.xyz` vers `http://mosquitto:9001` (le nom `mosquitto` est résolu dans le réseau Docker).
5. **Test final** : HiveMQ avec l'hôte `rover.gretier.xyz`, port 443, SSL coché ; les messages « bonjour » s'affichent en direct.

Le port 443 passe sur presque tous les réseaux (cégep, 4G), et la page HiveMQ, en https, n'accepte que le `wss`. L'ancien tunnel `pc-maison` (cours 4J5, `mqtt.gretier.xyz`) est éteint et n'a pas été modifié. Le broker est maintenant joignable depuis Internet : le mot de passe MQTT doit être long et unique.

## Problèmes rencontrés

| # | Problème | Cause | Correctif |
| --- | --- | --- | --- |
| 1 | « Missing Dependencies » à l'installation de VirtualBox | Liaisons Python optionnelles | Cliquer sur Oui, aucun impact |
| 2 | Première VM inutilisable (64 Mo, disque de 2 Go, NAT) | Valeurs minimales par défaut | VM recréée : 4096 Mo, 2 processeurs, 25 Gio, accès par pont |
| 3 | La VM redémarre sur l'installateur | ISO resté dans le lecteur | Retirer l'ISO dans Configuration, Stockage |
| 4 | « Login incorrect » | Identifiant différent du nom de machine ; clavier | Utiliser l'identifiant choisi à l'installation |
| 5 | `docker run hello-world` : permission denied | Utilisateur nouvellement ajouté au groupe `docker` | Se reconnecter (ou `sudo docker`) |
| 6 | Compilation Arduino très longue | Premier build du cœur ESP32 | Patienter, les suivants sont rapides |
| 7 | MQTT : échec, code 5 | Mot de passe MQTT du `secrets.h` non remplacé | Mettre le bon mot de passe, puis téléverser |
| 8 | Pare-feu Windows : `mdns-discovery.exe` | Outil de découverte réseau d'Arduino | Annuler, inutile pour un téléversement USB |
| 9 | Commande tapée comme un chemin (`Permission denied`, `Not a directory`) | Un chemin seul est exécuté comme un programme | Utiliser `cat >>` ou `nano` pour modifier le fichier |
| 10 | HiveMQ se déconnecte à l'abonnement ; « Invalid subscription string » | Sujet saisi invalide | Retaper le sujet à la main |
| 11 | `cloudflared` : « Provided Tunnel token is not valid » | L'identifiant du tunnel avait été mis à la place du jeton | Copier la commande Docker complète, ne garder que le texte après `--token` (commence par `eyJ`) |
| 12 | `chmod600 .env` : commande introuvable | Espaces oubliés | `chmod 600 .env` |

## Décisions

| Sujet | Décision | Statut |
| --- | --- | --- |
| Mission de référence | Reconnaissance en intérieur d'une pièce ou d'une zone inaccessible, pilotée depuis une autre pièce à partir de l'image transmise | Validée |
| V1 | Se déplacer sur commande, image en direct, arrêt automatique si la liaison est perdue, état du robot (batterie, liaison), mise à jour à distance (OTA) | Proposée |
| Hors V1 | GPS, inclinaison, 4G, caméra orientable, capteurs supplémentaires, bras, casque de réalité virtuelle, autres usages | Proposée |
| Réseau V1 | Wi-Fi et tunnel Cloudflare (wss, port 443) comme chemin principal ; accès local en dépannage ; sans réseau : arrêt automatique, mesures non conservées (V1) | Validée |
| Seuils des exigences | ≤ 1 s (commande, arrêt de sécurité, vidéo), erreur ≤ ±5 % sur la tension de batterie | Provisoires, à confirmer par des mesures |
| PCB | Carte de puissance (alimentation, ponts en H, mesure de tension) | Question posée à Tristan, réponse attendue |

## À faire

| Tâche | Statut |
| --- | --- |
| Instantané VirtualBox « tunnel-cloudflare » | À faire |
| Commande LED : l'ESP32 reçoit `rover/rover-01/cmd/drive`, règle la luminosité (PWM) et coupe après 1 s sans message | À faire |
| Télémétrie : capteur météo, accéléromètre, tension de batterie | À faire |
| Code Wi-Fi WPA-Enterprise (EAP) pour le réseau du cégep | À faire |
| Branches `main` et `dev`, première GitHub Action | À faire |
| Mesurer les courants des moteurs dès que le cégep rouvre | À faire |
| Commander un module de pont en H et une caméra | À faire |
| Concevoir la carte de puissance dans KiCad, après la réponse de Tristan | À faire |

## Questions ouvertes

- Hors Internet : décidé pour la V1, le robot s'arrête et les mesures de la coupure ne sont pas conservées ; les garder en mémoire est une amélioration pour plus tard.
- Le GPS est-il intégré à la carte LTE A7670E, et la 4G sera-t-elle utilisée après la V1 ?
- Rôle du PCB (carte de puissance ou carte porteuse de l'ESP32 et des capteurs) : réponse de Tristan attendue.

---

[Journal du 24 octobre](journal-2026-10-24.md) →
