guilatriche/rover/docs/journal/journal-2026-10-24.md

# Journal de bord du rover : 2026-10-24

> **Projet** : 243-6J7-LI (préparation 243-5J4-LI)  
> **Auteur** : Guillaume Retier  
> **Règle** : une entrée datée par séance. Aucun mot de passe ni jeton dans ce fichier.

**Sommaire** : [Résumé](#résumé) · [Ce qui a été fait](#ce-qui-a-été-fait) · [Problèmes rencontrés](#problèmes-rencontrés) · [Décisions](#décisions) · [À faire](#à-faire)

## Résumé

**En bref** : l'accès à la VM à distance et la commande de la LED par MQTT sont validés ; l'accéléromètre MPU6050 est branché.

**Points clés**

- **Accès à distance** : un terminal SSH s'ouvre dans le navigateur à l'adresse `rover-ssh.gretier.xyz`, protégé par Cloudflare Access.
- **Commande de la LED** : l'ESP32 règle la luminosité (PWM) selon un ordre reçu, garde la commande en mémoire (mode `latch`) tant que des signes de vie arrivent, et s'arrête environ 1 s après leur disparition.
- **Accéléromètre MPU6050** : branché, il publie son inclinaison sur MQTT et dispose d'un étalonnage mémorisé en flash ; l'alarme d'angle critique est remise à plus tard.

## Ce qui a été fait

### Accès SSH à distance

1. **Ports.** Clarification des trois portes du broker : 1883 (MQTT, réseau local), 9001 (MQTT sur WebSocket, réseau local), 443 (WebSocket chiffré chez Cloudflare, qui redirige vers le 9001 de la VM).
2. **Domaine.** `gretier.xyz` donne un nom stable et un certificat à la VM, quelle que soit son adresse locale. Il n'expose que ce qui est publié par une route.
3. **Reproduction de la méthode du cours 4J5** (applications « Browser SSH », aucune installation sur l'ordinateur) :
   - ajout de `extra_hosts: host.docker.internal:host-gateway` au service `cloudflared` du `docker-compose.yml` ;
   - route du tunnel `rover-vm` : `rover-ssh.gretier.xyz` vers `ssh://host.docker.internal:22` ;
   - application Access `rover-ssh` : Browser rendering SSH, règle existante réutilisée.
4. **Test** : terminal ouvert dans le navigateur, invite `rover@rover:~$`. Instantané VirtualBox pris après la mise en place.

### Anticipation de la 4G et du GPS (hors V1)

- Les bandes LTE de la carte A7670E (B1/B3/B5/B8/B20, Europe) ne couvrent pas Videotron (B4/B7/B12/B17). La SIM Sosh (France) est compatible en France. Pour l'Amérique du Nord : variante A7670G ou module SIM7600G-H.
- Le GNSS (GPS) est un module optionnel avec son antenne ; il fonctionne mal en intérieur. L'antenne LTE du kit (698-960 / 1710-2690 MHz) convient. Il manque la petite antenne GNSS carrée du kit : à demander au cégep.
- Phase 2 : bascule Wi-Fi vers 4G avec le même tunnel et les mêmes sujets MQTT.

### Accéléromètre MPU6050 (ajouté à la V1)

- Branchement : SDA sur GPIO 21, SCL sur GPIO 22. La LED est sur GPIO 14 (les GPIO 26, 27, 4 et 12 sont pris par le modem).
- Décision : l'inclinaison est **affichée** à l'opérateur (utile pour juger la puissance à fournir) et déclenche une **alarme** si elle devient critique (seuil provisoire ±5°, à régler). Aucun arrêt automatique sur l'inclinaison : un robot dans un lieu inaccessible ne doit pas s'arrêter parce qu'il est sur une pente.
- Un capteur en panne doit être signalé comme tel, pas affiché en zéros.

### Commande de la LED par MQTT

1. **Programme `rover_cmd_led`** : sujets `rover/rover-01/cmd/drive` (ordre de vitesse), `cmd/hb` (signe de vie), `status` (publié toutes les 2 s et à chaque changement de lien), `online` (testament).
2. **Deux modes de commande**, choisis dans le message `{"mode":"hold|latch","speed":0..100}` :
   - `hold` : le robot avance tant que la commande est répétée, et s'arrête environ 0,5 s après la dernière ;
   - `latch` : un seul appui suffit, la commande est gardée tant que le lien est vivant.
3. **Signe de vie** : un petit message `1` sur `cmd/hb`, répété toutes les 0,3 s. Il prouve que toute la chaîne (page de pilotage, tunnel, broker, Wi-Fi, ESP32) fonctionne. Seule sécurité automatique de la V1 : sans signe de vie pendant plus de 1 s (valeur provisoire), le robot s'arrête et **oublie** la commande ; au retour du lien il attend un nouvel ordre.
4. **Banc d'essai** : la boucle de signes de vie est lancée depuis la VM (`mosquitto_pub` dans le conteneur, mot de passe saisi avec `read -rs`, rien n'est écrit dans un fichier). Les ordres sont publiés à la main dans HiveMQ. La future page de pilotage remplacera les deux.
5. **Résultats du test `latch`** (journal HiveMQ du 24 octobre vers 10 h 50) :

| Essai | Résultat |
| --- | --- |
| Un seul ordre `speed:50`, signes de vie actifs, attente de plus de 10 s | LED allumée, statut `ok`, `speed:50` stable |
| Ordre `speed:0` | Arrêt, lien toujours `ok` |
| Arrêt de la boucle (Ctrl+C) | Statut `lost`, `speed:0` environ 1 s après le dernier signe de vie |
| Relance de la boucle sans nouvel ordre | `ok`, `speed:0` : le robot ne repart pas seul |

6. **Non testé** : le mode `hold` (il faut répéter l'ordre plusieurs fois par seconde, ce que HiveMQ ne sait pas faire) ; il sera testé avec la page de pilotage.

### Inclinaison du MPU6050 sur MQTT, avec étalonnage

1. **Test 04** : le MPU6050 publie `{"roll":..,"pitch":..}` une fois par seconde sur `rover/rover-01/imu`. Capteur posé sur le robot, à plat : environ roll -0,8° et pitch -3,1° (décalage du capteur et de son montage), bruit de ±0,3°. Si le capteur ne répond pas, le message est `{"imu":"error"}` (jamais de faux zéros).
2. **Test 05** : étalonnage sur ordre MQTT.
   - `go` sur `cmd/calib` : mesure pendant 2 s, la moyenne devient la référence « à plat ». `reset` l'efface.
   - La référence est mémorisée dans la flash de l'ESP32 (bibliothèque `Preferences`) : elle survit à une coupure d'alimentation.
   - L'angle publié est l'angle mesuré moins la référence ; le champ `calibrated` indique si une référence existe.
   - L'étalonnage est refusé si le capteur bouge pendant la mesure (écart de plus de 1,5°).
3. **Résultats** :

| Essai | Résultat |
| --- | --- |
| Étalonnage sur le robot posé à plat | `{"calib":"ok","refRoll":-0.90,"refPitch":-2.97}` ; ensuite roll et pitch proches de 0 (±0,5°), `calibrated:true` |
| Débranchement puis rebranchement de l'USB | Valeurs proches de 0 et `calibrated:true` sans nouvel étalonnage : la mémoire fonctionne |
| `go` pendant que le robot est secoué | `{"calib":"refused","reason":"motion"}` ; la référence n'est pas modifiée |

4. **Observation** : pendant une secousse, des angles comme 90° ou -40° apparaissent. Ce ne sont pas de vraies inclinaisons : un mouvement brusque s'ajoute à la gravité et fausse le calcul. L'alarme devra donc exiger un angle qui dure (temporisation d'environ 0,5 s) ; un lissage ou l'usage du gyroscope viendra si les fausses alarmes sont trop fréquentes.
5. **Réglages d'alarme envisagés** (non programmés) : seuil de ±5° sur roll ou pitch, temporisation de 0,5 s, retour à la normale sous 4°, seuil réglable par `cmd/tilt_limit` et mémorisé.

## Problèmes rencontrés

| # | Problème | Cause | Correctif |
| --- | --- | --- | --- |
| 1 | Hypothèse fausse : SSH à distance supposait d'installer `cloudflared` sur l'ordinateur | Confusion avec la méthode SSH classique | Le Browser rendering n'exige aucune installation |
| 2 | `localhost:22` inaccessible depuis le conteneur | `cloudflared` tourne dans Docker | `host.docker.internal` avec `extra_hosts` |
| 3 | Option « Browser rendering » introuvable à la création | Elle est dans l'onglet Basic information | La chercher dans le formulaire ou dans Edit |
| 4 | GPIO 26 réservé au modem dans le premier plan de branchement | Broches du modem de la carte A7670E | LED en 14, I2C en 21 et 22 |
| 5 | Lueur très faible de la LED à la mise sous tension | Faible tirage interne de la broche 14 pendant le démarrage | Normal ; sur le robot, ajouter des résistances de rappel à la masse (par exemple 10 kΩ) sur les entrées du pont en H |
| 6 | MPU6050 : valeurs figées à zéro, puis redevenues normales | Mauvais contact de masse sur le protoboard | Reconnecter ; test des valeurs brutes concluant. Sur le robot, utiliser des connexions soudées ou à connecteur |
| 7 | Statut `speed:0` affiché alors que la commande était acceptée | Le statut était publié avant l'application de la vitesse | Publier le statut après `appliquerLed` |
| 8 | Test `latch` sans boucle de signes de vie : LED coupée après 1 s | Sans signe de vie, le lien est déclaré perdu | Lancer la boucle avant l'ordre |
| 9 | Valeurs du test 04 sans le champ `calibrated` après un nouveau téléversement | L'ancien programme tournait encore | Téléverser le test 05 et vérifier la présence de `calibrated` |

## Décisions

| Sujet | Décision | Statut |
| --- | --- | --- |
| Administration à distance | SSH dans le navigateur par `rover-ssh.gretier.xyz`, protégé par Cloudflare Access (deux verrous : règle Access, puis mot de passe de la VM) | Validée |
| Inclinaison | Affichage plus alarme, sans arrêt automatique | Validée |
| Arrêt automatique | Seulement en cas de perte de liaison (signes de vie), seuil de 1 s à mesurer | Provisoire |
| Modes de commande | `hold` et `latch`, choisis dans la page de pilotage | Validée |
| Après une perte de lien | La commande est oubliée ; nouvel ordre nécessaire | Validée |
| Capteur en panne | Signalé comme tel, jamais affiché en zéros | Validée |
| Étalonnage de l'inclinaison | Référence « à plat » mesurée sur ordre, mémorisée en flash, refusée si le capteur bouge ; à refaire si le capteur est déplacé | Validée |
| Alarme d'inclinaison | Remise à plus tard | Reportée |

## À faire

| Tâche | Statut |
| --- | --- |
| Appliquer le correctif du statut dans `rover_cmd_led.ino`, téléverser, mesurer le délai d'arrêt avec les horodatages du moniteur série | À faire |
| Mettre à jour le dépôt : `firmware/`, `infra/docker-compose.yml`, `infra/README.md`, ce journal (vérifier qu'aucun `secrets.h`, `.env` ni `passwd` n'est ajouté) | À faire |
| Page de pilotage (une page web) : boutons Avancer et Stop, curseur de vitesse, choix `hold` / `latch`, signes de vie automatiques, affichage du statut ; test du mode `hold` | À faire |
| Passer la connexion de l'ESP32 par le tunnel (`wss`, port 443) avec vérification du certificat | À faire |
| Alarme d'inclinaison (`tilt_alarm`) : seuil, temporisation, retour à la normale, seuil réglable | À faire |
| Fusionner l'inclinaison et l'étalonnage dans le programme principal du robot | À faire |
| Tester le terminal SSH depuis un autre réseau (téléphone en 4G) | À faire |
| À la réouverture du cégep : mesures de courant des moteurs, pont en H, caméra, antenne GNSS, carte de puissance (résistances de rappel, pointes de courant du modem) | À faire |
| Attendre la réponse de Tristan sur le rôle du PCB | À faire |

---

← [Journal du 23 octobre](journal-2026-10-23.md) · [Journal du 25 octobre](journal-2026-10-25.md) →
