guilatriche/rover/docs/journal/journal-2026-11-10.md

# Journal de bord du rover : 2026-11-10

> **Projet** : 243-6J7-LI (préparation 243-5J4-LI)  
> **Auteur** : Guillaume Retier  
> **Heures** : locales (UTC − 5), sauf mention « UTC » (la VM est en UTC)  
> **Règle** : une entrée datée par séance. Aucun mot de passe ni jeton dans ce fichier.

**Sommaire** : [Résumé](#résumé) · [Lexique](#lexique) · [Ce qui a été fait](#ce-qui-a-été-fait) · [Problèmes rencontrés](#problèmes-rencontrés) · [Décisions](#décisions) · [Questions ouvertes](#questions-ouvertes) · [À faire](#à-faire)

## Résumé

**En bref** : première commande des roues depuis la page de pilotage, en mode série à paquets, puis recherche de la cause des pertes de liaison. Essais à la maison, roues en l'air.

**Points clés**

- **La commande depuis la page fait tourner les roues.** Chaque commande arrive à l'ESP32 et les paquets envoyés au Sabertooth sont justes (valeur et somme de contrôle affichées dans le moniteur série).
- **Sous 20 % de la page, les roues ne tournent pas, mais la commande arrive bien.** C'est le seuil des moteurs : roues en marche à l'octet 8 sur 127, arrêtées à l'octet 6 (vitesse en baisse).
- **Les pertes de liaison viennent du trajet de la page par Internet et Cloudflare.** Avec la page en réseau local, aucun retard ni perte pendant deux essais de 16 minutes, sur deux réseaux différents. Par Internet (`wss`), des retards jusqu'à 1,31 s et des coupures de la connexion de la page, qui arrêtent le robot 3 à 4 s.
- **Ces coupures sont des fermetures envoyées par Cloudflare.** Chrome enregistre une fermeture brutale (`ERR_CONNECTION_RESET`) sans changement de réseau ; Wireshark montre le paquet de fermeture (RST) arrivant de l'adresse de Cloudflare. Sur les 2,8 s sans connexion, 2,6 s viennent de l'attente de la page avant de se reconnecter.
- **Le VPN du portable (NordVPN) aggrave les coupures**, mais n'en est pas la seule cause. Il se relance seul quand le portable change de réseau.
- **La sécurité a toujours fonctionné** : à chaque perte, les roues se sont arrêtées, la commande a été oubliée et le robot n'est pas reparti seul.
- **Décisions** : interrupteur 3 du Sabertooth en bas (coupure lithium à 9,0 V) ; V1 en mode `hold` seulement ; arrêt des moteurs à 70° d'inclinaison conservé ; pile identifiée (LiPo 2200 mAh).

## Lexique

| Mot | Ce que c'est |
| --- | --- |
| Page de pilotage | La page web (`pilotage/index.html`) depuis laquelle l'opérateur envoie les ordres |
| Signe de vie | Petit message « 1 » envoyé par la page toutes les 0,3 s. Sans signe de vie pendant le délai fixé, le robot s'arrête et oublie la commande |
| `hold` | Mode « rester appuyé » : le robot roule tant que le bouton est tenu |
| `latch` | Mode « une pression » : un appui suffit, le robot garde la vitesse tant que les signes de vie arrivent |
| Octet de vitesse | Valeur de 0 à 127 envoyée au Sabertooth dans chaque paquet (127 = pleine puissance) |
| `wss` | Connexion de la page par Internet et le tunnel Cloudflare (`wss://rover.gretier.xyz/mqtt`) |
| Réseau local | Connexion directe de la page à la VM, sans Internet (`ws://<adresse de la VM>:9001`) |
| « session taken over » | Message de Mosquitto : un client s'est reconnecté sous le même nom, l'ancienne connexion est remplacée |
| Partage de connexion | Le téléphone (iPhone) sert de point d'accès Wi-Fi au portable et au robot |

## Ce qui a été fait

### Matériel et réglages

- **Pile des moteurs identifiée** (étiquette, photo) : Zeee, 2200 mAh, 11,1 V, 24,42 Wh, 35C, « High Performance Lithium Polymer Battery ». C'est une **LiPo 3S**. Même modèle que la pile utilisée avant l'échange au magasin.
- **Rôle de l'interrupteur 6 du Sabertooth** (notice) : en série à paquets, les interrupteurs 4, 5 et 6 fixent l'adresse ; 4, 5 et 6 en haut = adresse 128. L'interrupteur 6 reste donc en haut.
- **Écart relevé dans les documents** : « B B H H H H, 3 en bas » (journal du 7 novembre, comparatif) est contradictoire, car B B H H H H met l'interrupteur 3 en haut. Avec le 3 en bas, le réglage est **B B B H H H** (voir Décisions).
- **Position réelle pendant les essais de la soirée** : interrupteur 3 en haut (ON), soit **B B H H H H**, coupure pour pile lithium désactivée. Passé en bas vers 22 h 20 (Sabertooth coupé puis rallumé), soit B B B H H H.

### Programmes

| Programme | Rôle |
| --- | --- |
| `test_16_commande_moteurs_mqtt` | Commande des roues depuis la page, mode `hold` seulement, série à paquets (réunit `rover_cmd_led` et le test 12) |
| `test_17_commande_moteurs_latch_paquets` | Comme le test 16, avec `hold` et `latch`. Affiche dans le moniteur série, à chaque commande, la vitesse, l'octet envoyé et les octets exacts des paquets. Délai de perte de liaison porté à **2 s** pour ces essais (1 s au cahier des charges). Vitesse limitée : 100 % de la page = octet 40 sur 127 |

Les deux sont dans le dépôt (`firmware/tests/`, sans `secrets.h`) et dans `C:\Arduino` (avec `secrets.h`), où l'IDE Arduino les ouvre. `test_17` n'a pas été compilé hors de l'IDE avant le téléversement.

### Outils de surveillance utilisés

| Point | Outil | Ce qu'il montre |
| --- | --- | --- |
| Robot | Moniteur série (`[LIEN] perdu`, `[LIEN] ok`, `[CMD]`, `[PAQUETS]`) | Silence vu par le robot, commandes reçues, paquets envoyés |
| Serveur | Dans la VM : `mosquitto_sub` sur `rover/rover-01/cmd/hb`, horodaté, avec signalement de tout écart de plus de 0,6 s entre deux signes de vie | Si les signes de vie manquaient déjà en arrivant au serveur |
| Serveur | `docker logs -t --tail 50 mosquitto` | Connexions et déconnexions de la page et du robot, avec leur cause |
| Tunnel | `docker logs -t cloudflared` | Coupures du tunnel lui-même |
| Page | Console du navigateur (F12), heures affichées | Échecs de connexion de la page (`WebSocket connection … failed`) |
| Page | Enregistrement réseau de Chrome (`chrome://net-export`, lu avec netlog-viewer) | Raison exacte de chaque fermeture de connexion, changements de réseau |
| Portable | Wireshark, filtre sur l'adresse de Cloudflare et le drapeau RST | Qui envoie le paquet de fermeture (adresse, TTL) |
| Portable | Journal Windows « Microsoft-Windows-WLAN-AutoConfig/Operational » | Connexions et déconnexions du Wi-Fi |

Le détecteur au serveur a d'abord été vérifié en arrêtant volontairement les signes de vie (écart de 2,139 s affiché, puis 5,686 s lors d'un second contrôle). Une boucle de détection des interruptions de la VM (méthode du 25 octobre) a aussi tourné de 19 h 13 environ à 20 h 41 (seuil de 1,5 s), donc pendant les essais 7 à 11 : **aucune interruption de la VM affichée**.

L'horloge de la VM et celle du portable diffèrent d'environ 1 à 2 s (la VM n'est pas synchronisée, journal du 25 octobre) : les heures des deux côtés sont comparées à cette précision.

### Essais

Roues en l'air pour tous les essais. Sabertooth en série à paquets (adresse 128, 9600 bauds). Pile LiPo 3S avec fusible de 3 A.

| N° | But | Conditions de test | Résultats | Conclusion |
| --- | --- | --- | --- | --- |
| 1 | Vérifier qu'une commande de la page fait tourner les roues | `test_16`, mode `hold`, page en `wss`, Wi-Fi de la résidence | Au début, l'ESP32 ne se connecte pas au serveur (code −2, serveur injoignable). La VM avait pris l'adresse `192.168.202.56` (elle était `.76` jusqu'ici) ; `secrets.h` pointe maintenant vers cette adresse. Ensuite : les roues tournent tant que le bouton est tenu et s’arrêtent au relâchement, arrêt perçu comme instantané (constat de Guillaume, nombre d’appuis non noté, délai d’arrêt non chronométré) ; elles tournent à partir de 20 % de la page, en dessous pas de mouvement visible | La chaîne page → serveur → ESP32 → Sabertooth → roues fonctionne, et le relâchement arrête les roues |
| 2 | Savoir si l'absence de mouvement sous 20 % vient de la commande ou des moteurs | `test_17`, `latch`, vitesse montée jusqu'à 100 % puis descendue par pas de 5 % jusqu'à 0 | Chaque commande affiche `[CMD] recue` et un paquet juste. Exemples : 25 % → octet 10 ; 20 % → octet 8 ; 15 % → octet 6 ; 10 % → octet 4 ; 5 % → octet 2. Roues **en marche à 25 % et 20 %**, **arrêtées à 15 %** et en dessous. Réponse aux commandes perçue comme immédiate (non mesurée) | La commande arrive toujours. Sous l'octet 8 environ (5 à 6 % de la pleine puissance), les moteurs ne tournent pas : seuil mesuré en vitesse descendante, roues en l'air. Seuil de démarrage (vitesse montante) non mesuré |
| 3 | Comprendre pourquoi la vitesse maximale paraît plus faible que lors des essais précédents | Lecture de `test_16` et `test_17` | 100 % de la page = octet 40 sur 127 (`DATA_MAX = 40`), soit environ 31 % de la pleine puissance | Limitation voulue (valeur des tests 11 et 12), en attendant la mesure du courant |
| 4 | Voir si la liaison tient dans le temps | `test_17`, `latch` 25 %, page en `wss`, Wi-Fi de la résidence, VPN éteint ; début à 18:26:34 | **Une perte à 18:42:16** (après 15 min 41 s) : `[LIEN] perdu : aucun signe de vie depuis 2085 ms`. Pendant la perte, les statuts du robot continuent d'arriver à la page ; signal du robot de −55 à −61 dBm ; pas de redémarrage de l'ESP32. Liaison revenue environ 4 à 5 s après le dernier signe de vie. Les roues restent arrêtées jusqu'à un nouvel ordre (relance puis arrêt par Guillaume à 18:42:22 et 18:42:24) | La sécurité fonctionne. L'endroit de la coupure n'a pas été établi pour cette perte (le détecteur au serveur n'était pas encore lancé) |
| 5 | Voir l'effet d'un changement d'onglet en `latch` | `test_17`, `latch`, page en arrière-plan plus de 2 s | Les roues ne s'arrêtent pas | Normal avec la page actuelle : l'arrêt au changement d'onglet n'existe qu'en `hold`, et les signes de vie continuent en arrière-plan |
| 6 | Mesurer les écarts de signes de vie au serveur sur le Wi-Fi de la résidence | Même montage, détecteur au serveur, de 18:49 à 18:55 environ, VPN éteint | Écarts de 0,82 s (18:49:57) et 0,89 s (18:50:12) ; aucune perte | Le trajet de la page au serveur a lui aussi des à-coups |
| 7 | Même essai sur un autre réseau | Portable et robot sur le partage de connexion de l'iPhone (robot en `172.20.10.9`, −39 à −53 dBm ; VM en `172.20.10.10`), page en `wss`, de 19:04 à 19:24. **NordVPN s'était relancé seul** au changement de réseau | **Deux pertes.** 19:06:56 : robot `[LIEN] perdu` (2032 ms), trou de 3,3 s au serveur, Mosquitto « session taken over » pour la page à 19:06:56. 19:09:24 : robot `[LIEN] perdu` (2038 ms), trou de 6,6 s au serveur, échec de connexion de la page dans la console à 19:09:25, « session taken over » à 19:09:27. Petit écart de 0,74 s à 19:07:41. Le robot reste connecté au serveur pendant tout l'essai. `cloudflared` : erreurs seulement de 18:56 à 19:01 (changement de réseau), aucune aux heures des pertes | Les deux pertes sont des **coupures de la connexion de la page** : la page se reconnecte, alors que Mosquitto n'a pas vu l'ancienne connexion se fermer. La coupure se situe entre le navigateur et Cloudflare. Essai fait avec le VPN actif |
| 8 | Essai 1 de la série : iPhone, page par Internet, sans VPN | Partage de connexion, page en `wss`, VPN éteint, de 19:24 à 19:40 | 9 écarts au serveur, de 0,62 à **1,31 s** (8 entre 19:34:44 et 19:35:44, 1 à 19:40:12). Aucune reconnexion de la page. Aucune perte | Sans VPN, pas de coupure pendant 16 min, mais des retards jusqu'à 1,31 s |
| 9 | Essai 2 : iPhone, page en local | Partage de connexion, page en `ws://172.20.10.10:9001`, VPN éteint, de 19:41:55 à 19:58 environ | **Aucun écart, aucune perte** | Le Wi-Fi local, le portable, la VM et le robot n'ajoutent pas de retard |
| 10 | Essai 3 : résidence, page par Internet, sans VPN | Wi-Fi de la résidence, page en `wss`, VPN éteint, de 20:08:08 à 20:16:48 | 4 écarts de 0,62 à 0,81 s (20:08:59 à 20:09:18). **Une perte à 20:13:53** : robot `[LIEN] perdu` (2034 ms), trou de 3,3 s au serveur, Mosquitto « session taken over » pour la page à 20:13:53 | **Coupure de la connexion de la page aussi sans VPN** |
| 11 | Essai 4 : résidence, page en local | Wi-Fi de la résidence, page en `ws://192.168.202.56:9001`, VPN éteint, de 20:18:36 à 20:34 | **Aucun écart, aucune perte.** Mosquitto : page connectée depuis le portable à 20:18:06, aucune reconnexion ensuite | Même conclusion que l'essai 2, sur un second réseau |

| 12 | Voir si le Wi-Fi du portable s'est coupé aux heures des pertes | Journal Windows « WLAN-AutoConfig » depuis 18 h 40 | Événements seulement à 18:56:40 (passage sur l'iPhone), 19:59:18 à 19:59:23 (retour sur la résidence, 5 GHz) et 19:59:54 (passage manuel en 2,4 GHz). **Rien** à 18:42, 19:06, 19:09 ni 20:13 | Le Wi-Fi du portable ne s'est ni déconnecté ni reconnecté aux heures des pertes. Un changement d'antenne sans déconnexion n'apparaîtrait pas forcément dans ce journal |
| 13 | Savoir pourquoi le navigateur ferme la connexion | Enregistrement réseau de Chrome (`chrome://net-export`) de 20:08 à 22:04 ; page en `wss`, Wi-Fi de la résidence (2,4 GHz), VPN éteint | **21:06:48,403** : `ERR_CONNECTION_RESET` (code Windows 10054) sur la connexion de la page ; signes de vie envoyés toutes les 0,3 s et statuts reçus toutes les 2 s jusqu'à 56 ms avant. Reconnexion lancée à 21:06:50,870, établie à 21:06:51,029. **22:02:37,266** : même erreur ; reconnexion lancée à 22:02:39,870 (2,60 s plus tard), établie à 22:02:40,060 (0,19 s). Aucun événement « changement de réseau » pendant tout l'enregistrement. Aucune autre connexion fermée à 22:02 (les fermetures de 21:56 concernent des connexions Microsoft inactives) | La connexion n'est ni bloquée ni changée de réseau : elle est **fermée brutalement par l'autre côté**. La plus grande partie du trou vient de l'attente de 2 s de la page avant de se reconnecter (`reconnectPeriod: 2000`) |
| 14 | Savoir qui envoie la fermeture | Wireshark sur le Wi-Fi du portable, filtre `ip.addr == 172.64.80.1 && tcp.flags.reset == 1` (adresse de Cloudflare utilisée par la page, port local 50517) ; de 21:13 environ à 22:04 | **22:02:37** : un paquet de fermeture (RST) **arrive de `172.64.80.1`** vers le portable : TTL 57 (paquets ordinaires de Cloudflare : 58), identifiant IP 0, drapeau RST seul, numéro de séquence égal à celui attendu. Au serveur : trou de 3,29 s fini à 22:02:40 ; ensuite, robot à vitesse 0, liaison ok, pas de redémarrage. La connexion avait tenu 55 min 46 s (depuis 21:06:51) | La fermeture **vient du côté de Cloudflare** : pas du portable, ni d'un équipement proche (un paquet fabriqué par le routeur arriverait avec un TTL proche de 64). Sa forme correspond à un serveur qui ne connaît plus la connexion. Pourquoi Cloudflare perd la connexion : non établi |
| 15 | Vérifier qu'une reconnexion rapide de la page évite l'arrêt du robot lors d'une fermeture par Cloudflare | Page modifiée : `reconnectPeriod` passé de 2000 à **250 ms** dans `pilotage/index.html` (valeur vérifiée dans la console : 250). Page rechargée vers 22:11 ; `wss`, Wi-Fi de la résidence, VPN éteint ; `test_17`, `latch`, 25 % puis 0 % à partir de 22:23 (signes de vie actifs) ; Wireshark, détecteur au serveur et moniteur série. Interrupteur 3 du Sabertooth passé en bas vers 22:20 (Sabertooth coupé puis rallumé) : la LED bleue clignote 3 fois, ce que la notice décrit comme le nombre d'éléments lithium détectés | De 22:12 à 23:13 environ (1 h) : **aucune fermeture par Cloudflare** (aucun nouveau paquet RST dans Wireshark), aucune perte de liaison du robot. Enregistrement de Chrome : connexion de la page ouverte à 22:11:37 et jamais fermée jusqu'à la fin de l'enregistrement (23:19:05), aucun changement de réseau | **Non concluant** : la reconnexion rapide n'a pas pu être mise à l'épreuve, faute de fermeture pendant l'essai |
| 16 | Chercher la cause des petits retards au serveur | Même montage, de 22:12:57 à 23:12:55 | **31 retards de 0,60 à 1,11 s**, aucun trou plus long. Isolés la plupart du temps, y compris de 22:49 à 23:06 pendant que Guillaume n'utilisait pas le portable ; groupés à 22:25:46 → 22:25:55, 22:36:08 → 22:37:41, 23:06:55 → 23:07:12, 23:08:43 → 23:09:31 (8 retards, jusqu'à 1,11 s) et 23:10:53 → 23:12:55. Des groupes étaient aussi tombés à 20:09 et 21:09. **Pistes vérifiées** : minuteurs de la VM (`systemctl list-timers`) : aucun n'est horaire. Tâches Windows lancées de 23:07 à 23:11 : seule `RefreshCache` (`\Microsoft\Windows\Flighting\OneSettings\`) à 23:08:46 ; lancée à la main à 23:11:15, **aucun retard** ensuite | Cause des petits retards **non établie**. La VM, `RefreshCache` et l'utilisation du portable ne les expliquent pas. Ils n'existent qu'en `wss` (aucun en local, essais 9 et 11) et restent sous 1,2 s : sans arrêt du robot avec un délai de 2 s |

Les trous et pertes provoqués par des manipulations (changement d'adresse de la page, arrêt des signes de vie, mise en route, VPN) ne sont pas comptés.

**Bilan des essais 8 à 11** (sans VPN, roues en l'air, `latch` 25 %, délai de 2 s, une série par configuration) :

| Réseau | Page | Durée | Écarts de 0,6 à 1,3 s | Reconnexions de la page | Pertes |
| --- | --- | --- | --- | --- | --- |
| iPhone | `wss` | 16 min | 9 | 0 | 0 |
| iPhone | local | 16 min | 0 | 0 | 0 |
| Résidence | `wss` | 8 min 40 s | 4 | 1 | 1 |
| Résidence | local | 16 min | 0 | 0 | 0 |

**Ce qui est établi, dans ces conditions** : en réseau local, aucun incident sur les deux réseaux. Les retards et les coupures ne se produisent qu'avec la page par Internet et Cloudflare. Les coupures se situent entre le navigateur et Cloudflare (Mosquitto et le tunnel ne voient pas de fermeture). Les coupures sont des fermetures envoyées par Cloudflare (essais 13 et 14). **Non établi** : pourquoi Cloudflare ferme la connexion. Peu d'événements : une série par configuration, deux coupures analysées en détail.

**Petits retards au serveur** (0,6 à 1,3 s, sans arrêt du robot) relevés aussi pendant l'essai 14 : 21:09:00 à 21:09:17 (4 retards de 0,64 à 0,79 s), 21:28:43 (0,69 s), 22:03:54 (0,85 s). Ils ne se produisent qu'en `wss`. Deux groupes tombent à la même minute de l'heure (20:08:59 à 20:09:18 et 21:09:00 à 21:09:17) : observation, peut-être une coïncidence.

## Problèmes rencontrés

| # | Problème | Cause | Correctif |
| --- | --- | --- | --- |
| 1 | ESP32 : connexion au serveur impossible (code −2) | Adresse de la VM changée (`.76` → `.56` sur la résidence ; `172.20.10.10` sur l'iPhone) | Relever l'adresse avec `ip -br a` dans la VM et la mettre dans `MQTT_HOST` |
| 2 | La VM garde son ancienne adresse après le changement de réseau du portable | Pas de nouvelle demande d'adresse | Décocher puis recocher « Virtual Cable Connected » dans VirtualBox, puis `sudo networkctl renew enp0s3` |
| 3 | Sur le réseau de l'iPhone, l'ESP32 ne joint pas la VM restée sur la résidence | `MQTT_HOST` est une adresse privée, valable seulement sur le réseau local de la VM | Portable et robot sur le même réseau. Pour un robot pilotable de partout : connexion de l'ESP32 par le tunnel (tâche B6 du 25 octobre) |
| 4 | La page affiche « en ligne » sans avoir reçu aucun statut | Dans `majRobot()`, sans statut l'âge vaut 0 au lieu d'« inconnu » ; le serveur renvoie un ancien `online true` gardé | Non corrigé. Correction proposée : ajouter `\|\| !dernierStatutMs` à la première condition |
| 5 | En `latch`, changer d'onglet n'arrête pas les roues | Arrêt au changement d'onglet prévu seulement en `hold` ; le README de la page ne le précise pas | Non corrigé. Sans objet pour la V1 (`hold` seulement) |
| 6 | Roues arrêtées 2 s après chaque commande, après une reconnexion | « Se déconnecter » arrête aussi les signes de vie ; ils n'avaient pas été relancés | Relancer « Envoyer les signes de vie » après chaque reconnexion |
| 7 | NordVPN actif pendant l'essai 7 | Il se reconnecte seul quand le portable change de réseau | Le quitter complètement avant les essais et vérifier à chaque changement de réseau |
| 8 | `wss://172.20.10.10:9001` refusé | `wss` (chiffré) sur un port non chiffré | `ws://` en réseau local, `wss://rover.gretier.xyz/mqtt` par le tunnel |
| 9 | `docker logs --since 20m … \| grep` ne renvoie rien | Non établie | Utiliser `--tail 50` |
| 10 | Mots de passe Wi-Fi et MQTT visibles sur des captures d'écran | Fichier `secrets.h` affiché | Masquer `secrets.h` sur les captures ; changer les mots de passe (tâche B2 du 26 octobre) |

## Décisions

| Sujet | Décision | Pourquoi | Statut |
| --- | --- | --- | --- |
| Interrupteur 3 du Sabertooth | En bas : coupure à 3,0 V par élément, soit 9,0 V. Série à paquets : **B B B H H H** | La pile est une LiPo, qu'une décharge trop profonde abîme ; aucune autre protection n'existe aujourd'hui | Retenue (10 novembre) ; appliquée sur le Sabertooth vers 22 h 20 ; ferme la tâche C9 du 26 octobre |
| Pile des moteurs | LiPo 3S Zeee, 2200 mAh, 11,1 V, 35C | Étiquette | Constat ; ferme la partie « type et capacité » de la tâche C10 du 26 octobre |
| Pile faible | Le Sabertooth coupe les moteurs à 9,0 V. Le PCB mesurera des tensions en plusieurs points pour l'affichage et le dépannage (pile 12 V, pile 3,7 V de l'ESP32, autres points à lister) | Arrêt en cas de panne de batterie ; aide au dépannage | Retenue (10 novembre) |
| Mode de commande de la page en V1 | `hold` seulement ; pas de mode « un seul ordre » | Choix de conception | Retenue (10 novembre) ; remplace `hold` et `latch` du 24 octobre |
| Inclinaison | Arrêt des moteurs à 70° conservé | Choix de Guillaume | Retenue (10 novembre) ; remplace « sans arrêt automatique » du 24 octobre |
| Délai de perte de liaison | 2 s dans `test_17`, pour les essais seulement | Comparer avec les mesures | Essai ; le délai du projet reste à fixer |
| Reconnexion de la page | `reconnectPeriod` de 2000 à 250 ms dans `pilotage/index.html` | Sur les 2,8 s sans connexion après une fermeture par Cloudflare, 2,6 s venaient de cette attente (essai 13) | Essai ; à vérifier lors d'une prochaine fermeture (essai 15 non concluant) |

## Questions ouvertes

- **Pourquoi Cloudflare ferme-t-il la connexion de la page ?** Intervalles observés entre deux coupures : de 1 minute à 55 minutes. On ne peut pas l'empêcher de notre côté ; on peut réduire son effet en raccourcissant l'attente de la page avant de se reconnecter (aujourd'hui 2 s).
- **Service de la VM** (consigne 6J7 : un service développé, pas seulement installé) : options discutées. Servir la page et tenir un historique (aucune latence ajoutée), puis la mise à jour à distance ; une passerelle de commande ajouterait un maillon dans le trajet des commandes. Non tranché.
- **Boutons reculer et tourner** : nécessitent un nouveau programme (sens des moteurs) et un nouveau format de commande (champ « sens » ou vitesse signée et rotation). Non tranché. On ne sait pas encore si S1/M1 est le côté gauche ou droit.

## À faire

| Réf. | Tâche |
| --- | --- |
| D1 | Vérifier, lors d'une prochaine fermeture par Cloudflare, qu'avec `reconnectPeriod` à 250 ms le trou au serveur reste sous 1 s et que le robot ne s'arrête pas (Wireshark, détecteur au serveur, moniteur série) |
| D2 | Connexion de l'ESP32 par le tunnel (`wss`, port 443, vérification du certificat), pour un robot pilotable hors du réseau local (tâche B6 du 25 octobre) |
| D3 | Page de pilotage : corriger « en ligne » sans statut ; relancer ou signaler les signes de vie après une reconnexion ; préciser le README (arrêt au changement d'onglet en `hold` seulement) |
| D4 | Mesurer le seuil de démarrage des moteurs (vitesse montante), puis au sol avec la charge ; reporter le critère P2 de la série à paquets dans le comparatif |
| D5 | Mesurer le courant des moteurs avant d'augmenter `DATA_MAX` |
| D6 | Corriger « B B H H H H, 3 en bas » dans le comparatif, le plan d'essai et l'en-tête de `test_16` |
| D7 | Changer les mots de passe du broker et du Wi-Fi ; désactiver la connexion automatique de NordVPN |
| D8 | Valider `test_16` et `test_17` dans le dépôt (GitHub Desktop), en vérifiant que `secrets.h` n'y est pas |

---

← [Journal du 7 novembre](journal-2026-11-07.md)
