guilatriche/rover/docs/journal/journal-2026-10-25.md

# Journal de bord du rover : 2026-10-25

> **Projet** : 243-6J7-LI (préparation 243-5J4-LI)  
> **Auteur** : Guillaume Retier  
> **Heures** : locales (UTC − 4), sauf mention « UTC » (la VM est en UTC)  
> **Règle** : une entrée datée par séance. Aucun mot de passe ni jeton dans ce fichier.

**Sommaire** : [Résumé](#résumé) · [Ce qui a été fait](#ce-qui-a-été-fait) · [Problèmes rencontrés](#problèmes-rencontrés) · [Décisions](#décisions) · [À faire](#à-faire)

## Résumé

**En bref** : la page de pilotage fonctionne avec le robot ; les déconnexions ont été diagnostiquées sans que la cause soit établie ; premières mesures sur les moteurs.

**Points clés**

- **Page de pilotage** : une seule page web ; connexion au broker, statut, signes de vie, modes `hold` et `latch`.
- **Déconnexions** : une boucle de reconnexion toutes les 5 s (réglage `keepalive` trop serré, corrigé) et, plus grave, des **interruptions de la VM** (gels de plusieurs minutes au début, puis arrêts de 1,5 à 2 s environ toutes les 85 s). Ces arrêts ont été mesurés sous VirtualBox et sous VMware, avec ou sans réseau, et **ne sont pas expliqués**.
- **Décision** : continuer pour le moment avec la VM VirtualBox du portable ; une machine dédiée, plus sûre pour un fonctionnement 24 h sur 24, est reportée.
- **Test de bout en bout avec le robot** (voir « Diagnostic des déconnexions », B, point 18) : de 23:15 à 00:11 UTC (environ une heure), la liaison tient presque tout le temps, avec **deux épisodes de perturbation**. À 23:31 (20 s, trois passages à `lost`), les signes de vie arrivaient déjà en retard au broker (jusqu'à 1,3 s), en même temps que des pertes de `ping` mesurées depuis Windows. À 00:10 (un seul passage à `lost`), le retard n'est pas visible au broker. Le chemin réseau autour du portable (Wi-Fi, routeur) est suspecté, **sans que ce soit démontré**.
- **Moteurs** : premières mesures avec de simples piles et première réflexion sur la façon de tourner.
- **À venir** : les essais restants (programme de diagnostic, piles) sont prévus pour demain.

## Ce qui a été fait

### Page de pilotage (`pilotage/index.html`)

1. **Contenu** : connexion au broker par le tunnel (`wss`), affichage du statut du robot (en ligne, liaison, vitesse, mode, Wi-Fi, durée de marche), zone d'affichage de l'inclinaison (roulis, tangage, état du capteur) prévue dans le code mais **non testée** (voir plus bas), curseur de vitesse, bouton Avancer en mode `hold` (rester appuyé) ou `latch` (un appui), bouton Stop, signes de vie envoyés toutes les 0,3 s. Le mot de passe n'est jamais enregistré.
2. **Sécurités côté page** : toute perte de focus, changement d'onglet, fermeture ou changement de mode envoie un arrêt ; une reconnexion efface la commande en mémoire.
3. **Tests sur le robot** : connexion, statut, signes de vie et mode `latch` validés ; mode `hold` tenu plus de 60 s sans coupure lors d'un essai (un seul essai, pas concluant seul).
4. **Inclinaison : aucune valeur observée sur la page.** Le programme utilisé pour ces essais (`rover_cmd_led`) ne lit pas le MPU6050 et ne publie rien sur le sujet `imu`. Les mesures d'inclinaison viennent des essais séparés `test_04` et `test_05` (24 octobre), dont la fusion dans le programme principal n'est pas faite. La zone d'inclinaison de la page (roulis, tangage, pastille « capteur ») reste donc à vérifier avec de vraies données, y compris les cas « capteur en panne », « non étalonné » et « étalonné ».

5. **Correction de la case « Robot »** (fin de séance) : elle gardait « en ligne » quand la page n'était plus connectée au broker. Elle affiche maintenant « inconnu » dans ce cas, ou si aucun statut n'est arrivé depuis plus de 6 s, et « hors ligne » si le robot l'annonce ; la liaison, la vitesse, le mode, le signal et la durée de marche sont aussi effacés à la déconnexion. Vérifié en simulant le broker (connexion, statut, statut trop vieux, déconnexion, reconnexion, robot disparu) ; **à revérifier avec le vrai robot**.

### Diagnostic des déconnexions

#### A. Boucle de reconnexion de la page

Le journal du broker montrait le même client qui se reconnectait toutes les 5 s (« session taken over »). Le `keepalive` de la page était de 5 s. Avec 30 s, la page est restée connectée environ 18 minutes sans boucle. Le tunnel n'était pas en cause pour ce problème.

#### B. Interruptions de la VM

1. **Premiers constats** : une boucle de détection dans la VM a signalé des trous de 36 s, 485 s, 201 s, 976 s, et des messages `soft lockup` du noyau jusqu'à plus de 2000 s. Pendant ces gels, le robot (Wi-Fi) perd le broker et se reconnecte ensuite ; la page n'arrive plus à se reconnecter ; le terminal SSH direct répond avec quelques secondes de retard, puis plus du tout.
2. **Éliminé** : la mémoire et le processeur de l'ordinateur (16 % d'utilisation, 58 % de mémoire, disque à 0 %), la veille de Windows (les réglages d'alimentation étaient déjà sur « jamais »), d'autres VMs allumées (seule `vm-rover` tourne), les services `chrony` (pas synchronisé, il ne corrige donc pas l'horloge), les événements dans le journal de la VM aux heures des trous.
3. **Correction de la méthode** : la première boucle de détection, en secondes entières avec un seuil de 1 s, donnait de **faux trous**. Elle a été remplacée par une boucle à la milliseconde avec un seuil de 1,5 s, utilisée pour toutes les comparaisons ci-dessous. Les mesures plus anciennes avec l'ancien seuil sont à écarter.
4. **Mode d'exécution de VirtualBox** : VirtualBox 7.2.22 affiche « Execution Engine : native API » (il passe par l'hyperviseur de Windows) car « AMD-V is not available ». Les journaux `VBox.log` de quatre démarrages montrent ce repli, **même avec l'Intégrité de la mémoire désactivée et `bcdedit /set hypervisorlaunchtype off`**. Sur le portable, le noyau sécurisé de Windows tourne (`IsSecureKernelRunning = 1`, `KeyGuardEnabled = 1`) ; la seule fonctionnalité Windows de virtualisation activée est `VirtualMachinePlatform`. Windows 11 est en édition **Home** : pas de Hyper-V natif. Pas de désactivation supplémentaire de la sécurité de Windows.
5. **Pilote FTDI** : l'ancien pilote (version 2.12.12.0 de 2016) empêchait de réactiver l'Intégrité de la mémoire. Remplacé par la version 2.12.36.20 ; anciens paquets retirés ; l'Intégrité de la mémoire est de nouveau activée.
6. **NordVPN** : le taux de trous était environ 6 fois plus élevé avec NordVPN allumé. Il reste fermé pendant les mesures. Les trous existent aussi sans lui.
7. **Horloge de la VM sous VirtualBox** : au démarrage, le noyau a marqué `tsc` comme instable (écart de 52 ms sur 613 ms par rapport à `acpi_pm`). Comparaison du taux de trous, seuil de 1,5 s :

| Série | Trous | Taux |
| --- | --- | --- |
| `tsc` / `kvm-clock` | 3,5 à 5 par minute | trous jusqu'à plusieurs secondes |
| `acpi_pm`, interface KVM, 1re série | 2 en 7 min | ≈ 0,3 par minute |
| `acpi_pm`, interface KVM, 2e série | 9 en ≈ 11 min | ≈ 0,8 par minute, trous de 1,5 à 2,0 s |
| `acpi_pm`, interface Hyper-V | 5 en ≈ 12 min | ≈ 0,4 par minute, trous de 1,5 à 1,8 s |

   `acpi_pm` réduit nettement les trous par rapport à `tsc`, sans les supprimer, et les séries varient beaucoup d'une fois à l'autre.

8. **Interface de paravirtualisation Hyper-V** : bien appliquée (`GIM: Using provider 'HyperV'`), mais VirtualBox annonce le fournisseur sous le nom `VBoxVBoxVBox`, que Linux ne reconnaît pas comme Hyper-V : l'horloge Hyper-V n'est pas proposée et le réglage n'apporte rien à un invité Linux.
9. **VMware Workstation Pro 26H1** (même VM, exportée en `.ova` puis importée) : l'import a d'abord échoué (éléments OVF 2.0 non pris en charge), puis a réussi avec « Réessayer ». Au premier démarrage, la carte réseau n'était pas configurée : la configuration réseau (netplan) identifiait la carte par son adresse MAC de VirtualBox ; corrigé en remplaçant l'adresse MAC par celle de VMware. La VM a pris l'adresse `192.168.202.79` (au lieu de `.76`). Par défaut, l'horloge est `tsc`. Mesure, seuil de 1,5 s : **6 trous en 8 minutes**, durée de 1,6 à 2,0 s, séparés de **84 à 86 s** (21:29:28, 21:30:52, 21:32:18, 21:33:41, 21:35:05, 21:36:30 UTC). VMware n'améliore donc pas la situation.
10. **Sans réseau** : carte réseau de la VM déconnectée (vérifiée), toujours sous VMware : 3 trous en environ 7 minutes (1824, 1939 et 1636 ms à 21:49:54, 21:52:46 et 21:55:35 UTC), espacés de 169 à 172 s (≈ 2 × 85 s). Le pont Wi-Fi n'est donc pas la cause.
11. **Windows pendant ce temps** : la boucle PowerShell (seuil de 1,5 s) n'a signalé **aucun trou**. Le portable ne se fige pas ; la VM seule est interrompue, ou son horloge saute. Un `ping` depuis Windows ne permet pas de conclure (le routeur ne répond pas toujours aux `ping`, et la VM, sur la même carte Wi-Fi, répond sans quitter le portable).
12. **Limite de la mesure** : les trous sont mesurés avec l'horloge de la VM. Il n'est pas démontré par une mesure externe que la VM s'arrête vraiment. Ce qui compte pour le robot (retard des signes de vie) reste à mesurer avec le broker et la page.
13. **Réglages de Windows testés sans effet** (fin de séance) : mode d'alimentation déjà sur « Performances optimales » (portable branché), mode Efficacité non activé pour le processus de la VM, priorité de `vmware-vmx.exe` relevée (jusqu'à « Temps réel » : déconseillé, car peut geler le système). Les trous ont continué : par exemple 22:03:58, 22:05:23, 22:06:43, 22:09:32 et 22:12:22 UTC (1,7 à 1,9 s). Entre 21:55:35 et 22:03:58 (503 s, soit presque 6 périodes de 85 s) aucun trou n'a dépassé le seuil de 1,5 s, mais l'événement a repris sur la même grille : il est probablement constant, avec une amplitude variable. Une vidéo du Moniteur de ressources (processeur entre 5 et 9 %, `vmware-vmx.exe` à ≈ 0,4 %) ne montre aucune surcharge. La seule tâche planifiée de Windows exécutée pendant les 15 minutes précédentes était `RefreshCache` (`\Microsoft\Windows\Flighting\OneSettings\`, tâche interne de Windows, passage unique) : piste écartée. **3CX** (standard téléphonique complet installé sur le portable : serveur SIP, base de données, serveur média…) a été arrêté vers 22:22 UTC : les trous ont continué (22:26:16, 22:27:40 et 22:29:06 UTC, de 1,8 à 2,0 s, espacés de 84 et 86 s) : piste écartée. Note : les processus de 3CX ont aussi été arrêtés de force avant l'arrêt des services, ce qui peut avoir laissé la base de données 3CX dans un état à réparer au redémarrage.
14. **Test externe par `ping`** (carte réseau de la VM reconnectée, VM VMware) : `ping -t` depuis Windows vers la VM pendant environ 9 minutes (563 réponses, de 18:41 à 18:50 environ) : **toutes les réponses à moins de 1 ms** (deux fois « 1 ms »), alors que la boucle de la VM signalait des trous à 22:42:36, 22:43:59 et 22:49:43 UTC (1,7 à 2,0 s). Un arrêt réel de 0,7 à 0,9 s aurait retardé au moins une réponse (probabilité d'en éviter deux : environ 4 %). **La VM répond donc sans retard pendant ses « trous »** : ce sont des retards des minuteries ou de l'horloge de la VM, et pas un arrêt complet. Note : la carte réseau de la VM était restée déconnectée de 21:49 à environ 22:41 UTC, donc tous les trous de cette période (dont ceux des essais 3CX et Wi-Fi) ont eu lieu sans réseau. L'essai « configuration automatique du Wi-Fi désactivée » n'avait donc pas de sens pour la VM (à remettre en `yes`).
15. **Comparaison avec Linux dans WSL2** (Ubuntu, hyperviseur de Windows, même portable, en même temps) : la boucle de détection (seuil de 1,5 s, nanosecondes converties en millisecondes ; une première version affichait des nanosecondes par erreur) n'a signalé **aucun trou** de 22:43:58 à environ 22:50 UTC, pendant que la VM VMware en avait aux mêmes heures. Le portable et l'hyperviseur de Windows ne sont donc pas en cause ; le phénomène est propre aux VMs de VirtualBox et de VMware sur ce portable.
16. **Outils VMware dans la VM** : `open-vm-tools` et `vgauth` tournent dans la copie VMware (ils sont présents dans l'image d'origine), mais la synchronisation d'heure avec l'hôte est **désactivée** (`vmware-toolbox-cmd timesync status` : `Disabled`) : ils ne causent donc pas les sauts. L'horloge matérielle virtuelle (RTC) est en heure locale (4 h de retard sur l'UTC) et VMware remet l'heure juste au démarrage ; `chrony` n'arrive pas à se synchroniser (« System clock synchronized: no »). Aucun message du noyau sur l'horloge aux heures des trous (`dmesg`).
17. **Cause : non établie.** Ni l'horloge, ni l'interface de paravirtualisation, ni l'hyperviseur (VirtualBox ou VMware), ni le réseau, ni l'alimentation, ni la priorité du processus ne la font disparaître. Piste restante : l'hyperviseur de Windows maintenu actif par le noyau sécurisé, non désactivé (choix de sécurité). Des explications lues ailleurs (mode Efficacité, cœurs d'efficacité, tâche système toutes les 85 s) n'ont pas été confirmées : le processeur n'a pas de cœurs d'efficacité et les réglages correspondants n'ont rien changé.
18. **Test de bout en bout avec le robot** (programme `rover_cmd_led`, LED ; délai de perte de liaison 1 s ; broker dans la VM VirtualBox `.76`, VMware fermé ; page connectée avec les signes de vie envoyés). Les heures sont en UTC.
    - **Pertes constatées vers 23:03** (quatre passages à `lost`, 23:03:00, :17, :23 et :26, la LED s'est éteinte). L'`uptime` n'avait pas été relevé et la copie VMware était peut-être encore allumée (deux connecteurs `cloudflared` sur le même tunnel) : **cause non établie**.
    - **Redémarrages de la carte** : l'`uptime` retombe de 673 à 4 à 23:08:54, puis la carte redémarre de nouveau vers 23:11:19. À ces moments, le moniteur série USB (COM11) et l'IDE Arduino étaient en cours d'usage ; ouvrir le moniteur série réinitialise souvent cette carte, mais la cause n'a **pas été vérifiée** (la version actuelle du programme n'affiche pas la cause du redémarrage). Après le premier redémarrage, quatre passages à `lost` en 40 s (23:08:58, 23:09:09, :29 et :37), dont le premier est un artefact de reconnexion.
    - **`ping` vers le robot (`.77`)** : 175 réponses sans perte, de 4 à 405 ms (variation forte, typique d'une carte Wi-Fi avec économie d'énergie) ; plus tard, deux « délai d'attente dépassé » et des pics à 658 et 343 ms.
    - **Période calme** : de 23:15 à 23:30, aucun passage à `lost` (robot sur l'USB du portable, `uptime` continu depuis 23:11:19, signal entre −62 et −79 dBm, vitesses changées de 5 à 100 %).
    - **Perturbation de 23:31:02 à 23:31:21** : le détecteur d'écarts entre signes de vie mesurés **au broker** (heure d'arrivée avec fractions de seconde, signes de vie normalement espacés de 0,3 s) a relevé 15 écarts de 611 à 1304 ms. Les trois passages à `lost` (23:31:02, :08 et :13) suivent les écarts de 1303, 1304 et 916 ms. Les statuts du robot sont arrivés eux aussi en retard, en rafale (trois messages dans la même seconde à 23:31:13). L'`uptime` du robot est resté continu et le signal stable (−65 dBm). **Le `ping` horodaté depuis Windows a montré des pertes et des pics à la même heure** (vérifié au moment de la perte).
    - **Interprétation prudente** : le retard est déjà présent à l'arrivée au broker et dans les deux sens, et il apparaît aussi dans une mesure faite depuis Windows ; ce n'est donc ni le programme du robot, ni un simple défaut d'horloge de la VM. Le chemin commun est le réseau Wi-Fi du portable (page, tunnel, pont de la VM) ou le routeur ; **la distinction n'est pas faite**. Le robot était sur l'USB du portable pendant ces mesures, mais sur piles auparavant dans la journée : les deux conditions n'ont pas été comparées.
    - **À noter** : les rafales de commandes vues au moniteur série (plusieurs commandes à la même milliseconde) ne sont pas un indice de retard : elles correspondent à des balayages rapides du curseur de vitesse, à des heures sans perte.
    - **Wi-Fi du portable** (`netsh wlan show interfaces`, 19:37 locale) : carte Intel AX200, réseau « ILO 315 5G », bande 5 GHz, canal 44, 802.11ac, 400 Mbit/s en réception et en émission, signal 88 %, RSSI −49 dBm. La liaison du portable est donc forte ; le robot (2,4 GHz) est à −65 / −79 dBm. Le chemin commun suspecté reste le routeur (relais entre le 5 GHz du portable et le 2,4 GHz du robot) ou les réglages de la carte Wi-Fi du portable (économie d'énergie, recherche de réseaux), ou la liaison Internet pour les signes de vie seulement ; **aucun n'est démontré**.
    - **Nouveau test de 19:33:51 à 19:54 (locale)** : `ping` horodaté vers le robot, détecteur d'écarts (broker) et comptage des pertes, robot sur l'USB, VM VirtualBox seule. Résultat : **aucun passage à `lost`, aucun écart supérieur à 0,6 s** au broker. Le `ping` (environ 1 100 envois de 19:33:51 à 19:52:12) a perdu **un seul paquet** (19:34:27), sans effet sur les signes de vie ni sur le robot ; temps de réponse de 3 à 250 ms le plus souvent, trois pics à 570 ms (19:34:37), 394 ms (19:38:08) et 303 ms (19:39:15) ; la valeur typique change d'une minute à l'autre (3 à 57 ms vers 19:37:30, puis 60 à 130 ms à partir de 19:39:30), ce qui n'est pas un lien stable. À 23:53:51 UTC l'`uptime` du robot est de 2552 s : **42 minutes sans redémarrage** (depuis 23:11:19 UTC).
    - **Bilan provisoire** (USB, VM VirtualBox seule, sans NordVPN) : deux épisodes de perturbation en environ une heure (voir ci-dessous) ; le reste du temps, la liaison tient. Les rafales de commandes et l'économie d'énergie Wi-Fi n'ont pas été comparées avec le programme de diagnostic.
    - **Second épisode, de 20:09:44 à 20:10:37 (locale), soit 00:09:44 à 00:10:37 UTC** (même configuration) : un passage à `lost` à 00:10:01 UTC (la LED s'éteint ; la commande est oubliée, donc `speed` retombe à 0 et y reste, comme prévu). `uptime` continu (3522 s, aucun redémarrage), signal de −61 à −65 dBm. Le détecteur d'écarts n'a relevé qu'un écart de 603 ms, à 00:10:37, et **aucun à 00:10:01** (le détecteur tournait depuis environ 45 minutes : confirmé). Le `ping` horodaté a perdu deux paquets (« délai d'attente » affichés à 20:09:48 et 20:10:14, soit des paquets envoyés environ 4 s plus tôt) et montré un pic à 242 ms à 20:10:07 ; à 20:10:01 la réponse était normale (11 ms). Les anomalies sont groupées sur environ une minute mais **ne tombent pas à la même seconde**. Les signes de vie arrivaient donc régulièrement au broker au moment de la perte, et le silence vu par le robot s'est produit après le broker (VM, Wi-Fi ou routeur) ; ce profil est différent de celui de 23:31, où le retard était déjà présent à l'arrivée au broker. Deux épisodes ne suffisent pas pour conclure ; la version de diagnostic (`silence`, `reset`) doit aider à mieux voir le côté du robot.
    - **Un `ping` depuis un téléphone** vers le robot et vers le portable a échoué (« No route to host », alors que le téléphone était sur le même Wi-Fi) : le téléphone n'est pas sur le même réseau local (isolation, autre sous-réseau ou VPN) ; ce test est abandonné.

### Premières mesures sur les moteurs (piles, robot au sol)

Montage : deux moteurs du côté gauche (avant et arrière) reliés **en parallèle** sur la même pile ; les roues de droite tournent librement et suivent. Le robot avance droit.

| Mesure | Valeur |
| --- | --- |
| Tension d'une pile à vide | 1,558 V |
| Tension d'une pile avec les deux moteurs en marche, roues libres | ≈ 1,54 V |

| Tension | Trajet | Distance | Temps | Vitesse |
| --- | --- | --- | --- | --- |
| 1,5 V (une pile) | aller | 1,5 m | 19,16 s | ≈ 7,8 cm/s |
| 1,5 V (une pile) | retour | 1,5 m | 19,41 s | ≈ 7,7 cm/s |
| ≈ 3 V (deux piles en série) | aller | 1,5 m | 6,47 s | ≈ 23,2 cm/s |
| ≈ 3 V (deux piles en série) | retour | 1,5 m | 7,0 s | ≈ 21,4 cm/s |

Les deuxièmes essais ont donné des temps quasi identiques. Incertitudes : chronométrage à la main (environ ±0,3 s), tension du moteur non mesurée directement. Des essais préliminaires sur 30 cm (4 s à 1,5 V, 2 s à 3 V) étaient trop imprécis et sont remplacés par ceux-ci.

**Lecture** :
- Avec deux moteurs sur la même pile, la vitesse par roue ne change pas : en parallèle, chaque moteur reçoit la tension de la pile (la pile ne baisse que d'environ 0,02 V).
- Doubler la tension multiplie la vitesse par environ 2,8, pas par 2 : une partie de la tension sert à vaincre les frottements. D'après ces deux points seulement, le seuil de démarrage serait vers 0,7 V. À vérifier avec le pont en H et du PWM.
- Les roues non alimentées se laissent entraîner librement : **couper le moteur ne freine pas le robot**.

**Direction (réflexion de fin de séance, non mesurée)** : chaque roue a son moteur ; seuls les deux moteurs de gauche étaient alimentés, ceux de droite suivaient en roue libre, et le robot est allé **droit** sur 1,50 m. Explication probable : sur quatre roues, tourner oblige les roues à glisser de côté ; à 1,5 ou 3 V (soit 12 à 25 % de la tension nominale de 12 V des moteurs), la poussée d'un seul côté est trop faible pour vaincre ce frottement. Cela ne permet donc pas de conclure que le robot ne saura pas tourner : il le faudra avec les deux côtés en **sens contraire**, à une tension plus proche de la nominale, sur le sol réel. Commande prévue : deux groupes de moteurs (gauche avec avant et arrière, droite avec avant et arrière), un canal de pont en H par côté (PWM et sens), mélange `gauche = v + r`, `droite = v − r` (de −100 à +100) ; la commande `cmd/drive` devra porter une vitesse signée et une rotation (aujourd'hui seulement `speed` de 0 à 100) ; à la perte de liaison, les deux côtés s'arrêtent. Essai simple possible avec les piles : moteurs de gauche normaux, moteurs de droite avec la polarité inversée.

## Problèmes rencontrés

| # | Problème | Cause | Correctif |
| --- | --- | --- | --- |
| 1 | Page : bouton « Se déconnecter » pendant la reconnexion automatique | La page ne distinguait pas « connecté » et « en reconnexion » | États de connexion détaillés ajoutés à la page (reconnexion automatique, numéro d'essai, dernière cause) |
| 2 | Reconnexion en boucle toutes les 5 s | `keepalive` de 5 s trop serré pour la page | `keepalive` porté à 30 s dans la page |
| 3 | Gels de plusieurs minutes, puis arrêts de 1,6 à 2 s toutes les 85 s environ dans la VM | Non établie ; hyperviseur de Windows actif (noyau sécurisé), VirtualBox en « native API » ; mêmes trous avec VMware et sans réseau | Pour le moment, VM VirtualBox conservée (machine dédiée reportée) ; horloge `acpi_pm` comme atténuation seulement |
| 4 | Impossible de réactiver l'Intégrité de la mémoire | Ancien pilote FTDI (2016) incompatible | Pilote 2.12.36.20 installé, anciens paquets retirés |
| 5 | Page : champ « Robot » resté sur « en ligne » alors que la page était déconnectée | Dernier état retenu affiché sans condition | Corrigé le 25 octobre au soir : « inconnu » quand la page n'est pas connectée ou que le statut a plus de 6 s ; les autres valeurs affichées sont aussi effacées à la déconnexion ; vérifié avec un faux broker (10 étapes), **à revérifier avec le vrai robot** |
| 6 | Mesure de détection de trous donnait de faux positifs | Boucle en secondes entières avec un seuil de 1 s | Boucle à la milliseconde, seuil de 1,5 s |
| 7 | VM sans adresse IP après l'import dans VMware | La configuration réseau identifiait la carte par l'adresse MAC de VirtualBox | Adresse MAC remplacée dans le fichier netplan de la copie VMware |
| 8 | Adresse de la VM changée (`.76` sous VirtualBox, `.79` sous VMware) | Nouvelle adresse MAC, adresse donnée par le routeur | Le programme du robot vise encore `.76` : ne pas utiliser la copie VMware avec le robot sans mise à jour |
| 9 | Le robot passe à `lost` (LED éteinte) par moments, même avec le broker dans la VM VirtualBox seule | Signes de vie retardés de 0,6 à 1,3 s dès l'arrivée au broker, en même temps que des pertes de `ping` depuis Windows ; le chemin Wi-Fi du portable ou le routeur est suspecté, **non démontré** | Test à poursuivre ; version de diagnostic du programme du robot prête (cause du redémarrage, silence mesuré, Wi-Fi sans économie d'énergie), non encore téléversée ni testée |

## Décisions

| Sujet | Décision | Statut |
| --- | --- | --- |
| `keepalive` de la page | 30 s (la sécurité du robot repose sur les signes de vie, pas sur le `keepalive`) | Validée |
| Hébergement du broker pour la démonstration | Pour le moment : VM VirtualBox du portable. Une machine dédiée sous Linux, allumée en permanence, reste l'option pour un fonctionnement 24 h sur 24 (le tunnel Cloudflare resterait le même, donc aucune adresse publique ne changerait) | Reportée (décision du 25 octobre au soir) |
| VM sur le portable | Continuer avec la VM VirtualBox d'origine (adresse `.76`) pour le développement et les essais ; la copie VMware reste fermée, l'export `.ova` sert de sauvegarde | Validée (25 octobre au soir) |
| Sécurité de Windows | Ne pas désactiver davantage l'Intégrité de la mémoire ni le noyau sécurisé pour ce diagnostic | Validée |
| Délai de perte de liaison (arrêt du robot) | 1 s provisoire ; écart maximal mesuré entre deux signes de vie au broker : 1,3 s (23:31 UTC, trois passages à `lost`) ; à fixer d'après les mesures réelles des signes de vie (voir A2) ; à peser avec la distance parcourue (≈ 20 à 70 cm pour 3 s à 7 à 23 cm/s) | À trancher après mesure |
| Arrêt du robot | À décider : roue libre ou freinage actif (le robot ne freine pas seul) | À trancher avec le pont en H |
| Vitesse maximale | Plafonner la commande (100 % ne doit pas être la tension maximale) | À régler après mesures |
| Zone morte du PWM | À mesurer (seuil de démarrage vers 0,7 V selon deux points) | À mesurer |

## À faire

### Priorité 1 : liaison du robot et diagnostic

| Réf. | Tâche | Critère de réussite |
| --- | --- | --- |
| A1 | Téléverser la version de diagnostic de `rover_cmd_led.ino` (fichier préparé, non compilé, non testé) : champs `reset` et `silence` dans le statut, messages série détaillés, `WiFi.setSleep(false)` | Programme compilé et téléversé ; le statut MQTT contient `reset` et `silence` ; ancienne version conservée dans le dépôt tant que le test n'est pas concluant |
| A2 | Essais de liaison de 30 minutes sur l'USB, puis de 30 minutes sur piles, avec comptage des passages à `lost`, détecteur d'écarts de signes de vie au broker (seuil 0,6 s) et `ping` horodaté vers le robot | Nombre de passages à `lost`, écart maximal mesuré, cause de tout redémarrage (`reset`) ; temps de réponse du `ping` comparés à ceux d'aujourd'hui (3 à 250 ms, pics à 570 ms) |
| A3 | Localiser le retard : Wi-Fi du portable, routeur ou liaison Internet (le portable est en 5 GHz, canal 44, −49 dBm) ; essayer le portable en câble Ethernet avec le pont de la VM sur cette carte ; lancer en parallèle un `ping` horodaté du robot depuis la VM (`ping -D 192.168.202.77`) et depuis Windows, pour voir si la perte du dernier tronçon apparaît des deux côtés | Une cause désignée par une mesure, ou écartée |
| A4 | Fixer le délai de perte de liaison | Délai supérieur à l'écart maximal mesuré, avec une distance d'arrêt acceptable (≈ 20 à 70 cm pour 3 s à 7 à 23 cm/s) ; à valider avec Tristan |

Conditions de mesure : NordVPN fermé, une seule VM allumée (VirtualBox), moniteur série et câble USB non manipulés pendant la mesure (la carte redémarre), onglet de la page visible avec les signes de vie actifs.

### Priorité 2 : micrologiciel et page de pilotage

| Réf. | Tâche | Critère de réussite |
| --- | --- | --- |
| B1 | Fusionner l'inclinaison et l'étalonnage (`test_04`, `test_05`) dans le programme principal du robot | Le sujet `imu` publie des valeurs réelles |
| B2 | Vérifier l'affichage de l'inclinaison dans la page (valeurs, capteur en panne, étalonné ou non) | Trois cas validés avec de vraies données |
| B3 | Champ « Robot » de la page : l'état « en ligne » ou « hors ligne » reste affiché même quand la page n'est plus connectée au broker, ce qui est faux. Afficher « inconnu » tant que la page n'est pas connectée, ou si aucun statut n'est arrivé depuis plus de 6 s | Page déconnectée : « inconnu » ; page reconnectée : « en ligne » ou « hors ligne » d'après le robot. **Corrigé et vérifié avec un faux broker le 25 octobre ; à revérifier avec le vrai robot** |
| B4 | Alarme d'inclinaison (seuil, temporisation, retour à la normale, seuil réglable) | Alarme sans arrêt automatique du robot |
| B5 | Téléversement sans câble (OTA, option B) | Mise à jour par le broker, refus si le robot roule |
| B6 | Passer la connexion de l'ESP32 par le tunnel (`wss`, port 443) avec vérification du certificat | Le robot n'a plus besoin de l'adresse locale du broker |
| B7 | Ajouter `pilotage/index.html` au dépôt | Fichier publié, sans secret. **Préparé le 25 octobre (avec un README de la page), à publier** |

### Priorité 3 : moteurs et puissance

| Réf. | Tâche | Critère de réussite |
| --- | --- | --- |
| C1 | Mesures sur les moteurs : troisième point de tension (par exemple 4,5 V), courant au multimètre | Courbe vitesse en fonction de la tension (≥ 3 points) et courant à vide |
| C2 | Pont en H à deux canaux (un par côté) : PWM, sens, zone morte | Seuil de démarrage mesuré (≈ 0,7 V selon deux points) |
| C3 | Rotation sur place : essai avec les piles (moteurs de droite en polarité inversée), puis avec une tension proche de 12 V sur le sol réel | Rotation obtenue ou tension minimale notée selon le sol |
| C4 | Commande `cmd/drive` avec vitesse signée et rotation (mélange gauche = v + r, droite = v − r) ; arrêt des deux côtés à la perte de liaison | Spécification écrite ; page mise à jour |
| C5 | Arrêt : roue libre ou freinage actif ; plafond de la vitesse maximale | Choix documenté d'après mesures |

### Suivi et dépendances

| Réf. | Tâche | Statut |
| --- | --- | --- |
| D1 | Réponse de Tristan sur le rôle du PCB | En attente |
| D2 | À la réouverture du cégep : mesures de courant des moteurs, pont en H, caméra, antenne GNSS, carte de puissance | À planifier |
| D3 | Un pack NiMH 12 V, soit 10 piles AA NiMH de 1,2 V en série, de préférence 2000 mAh ou plus avec un chargeur NiMH. | |

---

← [Journal du 24 octobre](journal-2026-10-24.md) · [Journal du 26 octobre](journal-2026-10-26.md) →
