guilatriche/rover/(commit log)

2026-10-23 ajout de .gitignore
2026-10-24 Commande LED, signes de vie, inclinaison MPU6050 étalonnée, accès SSH
2026-10-26 Ajouter la page de pilotage et le journal du 25 octobre
2026-10-26 Add battery pack specifications to journal entry
2026-10-26 Revise journal entry for motor controller testing
    Updated observations and tasks related to motor controller testing, including clarifications on DIP switch settings and potentiometer behavior.
2026-11-06 Esp32-controleur Sabertooth
2026-11-07 Journal du 7 novembre, comparatif des modes de commande et schémas
2026-11-10 firmwares de test
2026-11-11 test de la latence esp32-vm-tunnel
